ivop/osi600d/doc/osi600d-reference.pdf

OSI600D

Source: | kicad/OSI600D.kicad_sch
Date: | Wed 23 Apr 2025 11:26:50 PM CEST
Reference(s) Value | LibPart | Footprint
C1 | 10mF | Device:C_Polarized | Capacitor_THT:C_Radial_D10.0mm_H16.0mm_P5.00mm
C2 | 10n | Device:C_Polarized | Capacitor_THT:CP_Axial_L10.0mm_D4.5mm_P15.00mm_Horizontal
C3 | 33u | Device:C_Polarized | Capacitor_THT:CP_Axial_L10.0mm_D4.5mm_P15.00mm_Horizontal
C4 | 33u | Device:C_Polarized | Capacitor_THT:CP_Axial_L10.0mm_D4.5mm_P15.00mm_Horizontal
C5 | 47u | Device:C_Polarized | Capacitor_THT:CP_Axial_L10.0mm_D4.5mm_P15.00mm_Horizontal
C6 | 150p | Device:C | OSI600D:C_Disc_D7.5mm_W2.5mm_P7.50mm
C7 | 1n | Device:C | OSI600D:C_Disc_D7.5mm_W2.5mm_P7.50mm
C8 | 100n | Device:C | Capacitor_THT:C_Disc_D5.1mm_W3.2mm_P5.00mm
C9 | 68p | Device:C | OSI600D:C_Disc_D7.5mm_W2.5mm_P7.50mm
C10 | 10n | Device:C | OSI600D:C_Disc_D7.5mm_W2.5mm_P7.50mm
C11 | 100n | Device:C | OSI600D:C_Disc_D7.5mm_W2.5mm_P7.50mm
C12 | 1n | Device:C | OSI600D:C_Disc_D7.5mm_W2.5mm_P7.50mm
C13 | 10n | Device:C | OSI600D:C_Disc_D7.5mm_W2.5mm_P7.50mm
C55 | 1n | Device:C | OSI600D:C_Disc_D7.5mm_W2.5mm_P7.50mm
C57 | 27p | Device:C | Capacitor_THT:C_Disc_D4.3mm_W1.9mm_P5.00mm
C60 | 1n | Device:C | OSI600D:C_Disc_D7.5mm_W2.5mm_P7.50mm
C61 | 150p | Device:C | OSI600D:C_Disc_D7.5mm_W2.5mm_P7.50mm
C62 | 100n | Device:C | OSI600D:C_Disc_D7.5mm_W2.5mm_P7.50mm
C63 | 47u | Device:C_Polarized | Capacitor_THT:CP_Axial_L11.0mm_D5.0mm_P18.00mm_Horizontal
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
JP28 | Jumper_2_Bridged | Jumper:Jumper_2_BridgeOSI600D:Closed_PinHeader_1x02_P2.54mm_Vertical
JP29 | Jumper_2_Bridged | Jumper:Jumper_2_BridgeOSI600D:Closed_PinHeader_1x02_P2.54mm_Vertical
JP30 | Jumper_2_Open | Jumper:Jumper_2_Open Connector_PinHeader_2.54mm:PinHeader_1x02_P2.54mm_Vertical
JP31 | Jumper_2_Open | Jumper:Jumper_2_Open Connector_PinHeader_2.54mm:PinHeader_1x02_P2.54mm_Vertical
KEY1 | 1 | OSI600D:KEY SWITCH OSI600D:SW_Cherry_MX_PCB_1.00u
KEY2 | 8 | OSI600D:KEY SWITCH OSI600D:SW_Cherry_MX_PCB_1.00u
KEY3 | . | OSI600D:KEY SWITCH OSI600D:SW_Cherry_MX_PCB_1.00u
KEY4 | W | OSI600D:KEY SWITCH OSI600D:SW_Cherry_MX_PCB_1.00u
KEY5 | S | OSI600D:KEY SWITCH OSI600D:SW_Cherry_MX_PCB_1.00u
KEY6 | X | OSI600D:KEY SWITCH OSI600D:SW_Cherry_MX_PCB_1.00u
KEY7 | Q | OSI600D:KEY SWITCH OSI600D:SW_Cherry_MX_PCB_1.00u
KEY8 | REPT | OSI600D:KEY SWITCH OSI600D:SW_Cherry_MX_PCB_1.00u
KEY9 | 2 | OSI600D:KEY SWITCH OSI600D:SW_Cherry_MX_PCB_1.00u
KEY10 | 9 | OSI600D:KEY SWITCH OSI600D:SW_Cherry_MX_PCB_1.00u
KEY11 | L | OSI600D:KEY SWITCH OSI600D:SW_Cherry_MX_PCB_1.00u
KEY12 | E | OSI600D:KEY SWITCH OSI600D:SW_Cherry_MX_PCB_1.00u
KEY13 | D | OSI600D:KEY SWITCH OSI600D:SW_Cherry_MX_PCB_1.00u
KEY14 | C | OSI600D:KEY SWITCH OSI600D:SW_Cherry_MX_PCB_1.00u
KEY15 | A | OSI600D:KEY SWITCH OSI600D:SW_Cherry_MX_PCB_1.00u
KEY16 | CTRL | OSI600D:KEY SWITCH OSI600D:SW_Cherry_MX_PCB_1.00u
KEY17 | 3 | OSI600D:KEY SWITCH OSI600D:SW_Cherry_MX_PCB_1.00u
KEY18 | 0 | OSI600D:KEY SWITCH OSI600D:SW_Cherry_MX_PCB_1.00u
KEY19 | O | OSI600D:KEY SWITCH OSI600D:SW_Cherry_MX_PCB_1.00u
KEY20 | R | OSI600D:KEY SWITCH OSI600D:SW_Cherry_MX_PCB_1.00u
KEY21 | F | OSI600D:KEY SWITCH OSI600D:SW_Cherry_MX_PCB_1.00u
KEY22 | V | OSI600D:KEY SWITCH OSI600D:SW_Cherry_MX_PCB_1.00u
KEY23 | Z | OSI600D:KEY SWITCH OSI600D:SW_Cherry_MX_PCB_1.00u
KEY24 | ESC | OSI600D:KEY SWITCH OSI600D:SW_Cherry_MX_PCB_1.00u
KEY25 | 4 | OSI600D:KEY SWITCH OSI600D:SW_Cherry_MX_PCB_1.00u
KEY26 | : | OSI600D:KEY SWITCH OSI600D:SW_Cherry_MX_PCB_1.00u
KEY27 | LF | OSI600D:KEY SWITCH OSI600D:SW_Cherry_MX_PCB_1.00u
KEY28 | T | OSI600D:KEY SWITCH OSI600D:SW_Cherry_MX_PCB_1.00u
KEY29 | G | OSI600D:KEY SWITCH OSI600D:SW_Cherry_MX_PCB_1.00u
KEY30 | B | OSI600D:KEY SWITCH OSI600D:SW_Cherry_MX_PCB_1.00u
KEY31 | SPACE | OSI600D:KEY SWITCH OSI600D:SW_Cherry_MX_PCB_1.00u
KEY32 | 5 | OSI600D:KEY SWITCH OSI600D:SW_Cherry_MX_PCB_1.00u
KEY33 | - | OSI600D:KEY SWITCH OSI600D:SW_Cherry_MX_PCB_1.00u
KEY34 | RET | OSI600D:KEY SWITCH OSI600D:SW_Cherry_MX_PCB_1.50u
KEY35 | Y | OSI600D:KEY SWITCH OSI600D:SW_Cherry_MX_PCB_1.00u

KEY36 | H | OSI600D:KEY SWITCH OSI600D:SW_Cherry_MX_PCB_1.00u
KEY37 | N | OSI600D:KEY SWITCH OSI600D:SW_Cherry_MX_PCB_1.00u
KEY38 | ?/ | OSI600D:KEY SWITCH OSI600D:SW_Cherry_MX_PCB_1.00u
KEY39 | 6 | OSI600D:KEY SWITCH OSI600D:SW_Cherry_MX_PCB_1.00u
KEY40 | RUB | OSI600D:KEY SWITCH OSI600D:SW_Cherry_MX_PCB_1.00u
KEY41 | U | OSI600D:KEY SWITCH OSI600D:SW_Cherry_MX_PCB_1.00u
KEY42 | J | OSI600D:KEY SWITCH OSI600D:SW_Cherry_MX_PCB_1.00u
KEY43 | M | OSI600D:KEY SWITCH OSI600D:SW_Cherry_MX_PCB_1.00u
KEY44 | ; | OSI600D:KEY SWITCH OSI600D:SW_Cherry_MX_PCB_1.00u
KEY45 | LSHFT | OSI600D:KEY SWITCH OSI600D:SW_Cherry_MX_PCB_1.50u
KEY46 | 7 | OSI600D:KEY SWITCH OSI600D:SW_Cherry_MX_PCB_1.00u
KEY47 | I | OSI600D:KEY SWITCH OSI600D:SW_Cherry_MX_PCB_1.00u
KEY48 | K | OSI600D:KEY SWITCH OSI600D:SW_Cherry_MX_PCB_1.00u
KEY49 | , | OSI600D:KEY SWITCH OSI600D:SW_Cherry_MX_PCB_1.00u
KEY50 | P | OSI600D:KEY SWITCH OSI600D:SW_Cherry_MX_PCB_1.00u
KEY51 | RSHFT | OSI600D:KEY SWITCH OSI600D:SW_Cherry_MX_PCB_1.50u
KEY52 | SHFTLK | OSI600D:KEY SWITCH OSI600D:SW_Cherry_MX_PCB_1.00u
KEY53 | BREAK | Switch:SW_Push | OSI600D:SW_Cherry_MX_PCB_1.00u
LED1 | LED | Device:LED | LED_THT:LED_D5.0mm
PIN1 | JUMPER_PIN | OSI600D:JUMPER_PIN Connector_PinHeader_2.54mm:PinHeader_1x01_P2.54mm_Vertical
PIN2 | JUMPER_PIN | OSI600D:JUMPER_PIN Connector_PinHeader_2.54mm:PinHeader_1x01_P2.54mm_Vertical
PIN3 | JUMPER_PIN | OSI600D:JUMPER_PIN Connector_PinHeader_2.54mm:PinHeader_1x01_P2.54mm_Vertical
PIN4 | JUMPER_PIN | OSI600D:JUMPER_PIN Connector_PinHeader_2.54mm:PinHeader_1x01_P2.54mm_Vertical
PIN5 | JUMPER_PIN | OSI600D:JUMPER_PIN Connector_PinHeader_2.54mm:PinHeader_1x01_P2.54mm_Vertical
PIN6 | JUMPER_PIN | OSI600D:JUMPER_PIN Connector_PinHeader_2.54mm:PinHeader_1x01_P2.54mm_Vertical
PIN7 | JUMPER_PIN | OSI600D:JUMPER_PIN Connector_PinHeader_2.54mm:PinHeader_1x01_P2.54mm_Vertical
PIN8 | JUMPER_PIN | OSI600D:JUMPER_PIN Connector_PinHeader_2.54mm:PinHeader_1x01_P2.54mm_Vertical
PIN9 | JUMPER_PIN | OSI600D:JUMPER_PIN Connector_PinHeader_2.54mm:PinHeader_1x01_P2.54mm_Vertical
PIN10 | JUMPER_PIN | OSI600D:JUMPER_PIN Connector_PinHeader_2.54mm:PinHeader_1x01_P2.54mm_Vertical
PIN11 | JUMPER_PIN | OSI600D:JUMPER_PIN Connector_PinHeader_2.54mm:PinHeader_1x01_P2.54mm_Vertical
PIN12 | JUMPER_PIN | OSI600D:JUMPER_PIN Connector_PinHeader_2.54mm:PinHeader_1x01_P2.54mm_Vertical
PIN13 | JUMPER_PIN | OSI600D:JUMPER_PIN Connector_PinHeader_2.54mm:PinHeader_1x01_P2.54mm_Vertical
PIN14 | JUMPER_PIN | OSI600D:JUMPER_PIN Connector_PinHeader_2.54mm:PinHeader_1x01_P2.54mm_Vertical
PIN15 | JUMPER_PIN | OSI600D:JUMPER_PIN Connector_PinHeader_2.54mm:PinHeader_1x01_P2.54mm_Vertical
PIN16 | JUMPER_PIN | OSI600D:JUMPER_PIN Connector_PinHeader_2.54mm:PinHeader_1x01_P2.54mm_Vertical
PIN17 | JUMPER_PIN | OSI600D:JUMPER_PIN Connector_PinHeader_2.54mm:PinHeader_1x01_P2.54mm_Vertical
PIN18 | JUMPER_PIN | OSI600D:JUMPER_PIN Connector_PinHeader_2.54mm:PinHeader_1x01_P2.54mm_Vertical
Q1 | 2N5226 | Transistor_BJT:2N3906 Package_TO_SOT_THT:TO-92_Inline_Wide
Q2 | 2N5225 | Transistor_BJT:2N2219 Package_TO_SOT_THT:TO-92_Inline_Wide
R1 | 4K7 | Device:R | Resistor_THT:R_Axial_DIN0207_L6.3mm_D2.5mm_P2.54mm_Vertical
R2 | 4K7 | Device:R | Resistor_THT:R_Axial_DIN0207_L6.3mm_D2.5mm_P2.54mm_Vertical
R3 | 4K7 | Device:R | Resistor_THT:R_Axial_DIN0207_L6.3mm_D2.5mm_P2.54mm_Vertical
R4 | 4K7 | Device:R | Resistor_THT:R_Axial_DIN0207_L6.3mm_D2.5mm_P2.54mm_Vertical
R5 | 4K7 | Device:R | Resistor_THT:R_Axial_DIN0207_L6.3mm_D2.5mm_P2.54mm_Vertical
R6 | 4K7 | Device:R | Resistor_THT:R_Axial_DIN0207_L6.3mm_D2.5mm_P2.54mm_Vertical
R7 | 4K7 | Device:R | Resistor_THT:R_Axial_DIN0207_L6.3mm_D2.5mm_P2.54mm_Vertical
R8 | 4K7 | Device:R | Resistor_THT:R_Axial_DIN0207_L6.3mm_D2.5mm_P2.54mm_Vertical
R9 | 220 | Device:R | Resistor_THT:R_Axial_DIN0207_L6.3mm_D2.5mm_P2.54mm_Vertical
R10 | 4K7 | Device:R | Resistor_THT:R_Axial_DIN0207_L6.3mm_D2.5mm_P2.54mm_Vertical
R11 | 4K7 | Device:R | Resistor_THT:R_Axial_DIN0207_L6.3mm_D2.5mm_P2.54mm_Vertical
R32 | 1K | Device:R | Resistor_THT:R_Axial_DIN0207_L6.3mm_D2.5mm_P2.54mm_Vertical
R33 | 10K | Device:R | Resistor_THT:R_Axial_DIN0207_L6.3mm_D2.5mm_P2.54mm_Vertical
R34 | 10K | Device:R | Resistor_THT:R_Axial_DIN0207_L6.3mm_D2.5mm_P2.54mm_Vertical

R35 | 470 | Device:R | Resistor_THT:R_Axial_DIN0207_L6.3mm_D2.5mm_P2.54mm_Vertical
R36 | 470 | Device:R | Resistor_THT:R_Axial_DIN0207_L6.3mm_D2.5mm_P2.54mm_Vertical
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
U12 | BASIC 4 | OSI600D:2316B{slash}26Package_DIP:DIP-24_W15.24mm_Socket_LongPads
U13 | 2316B/2716 | OSI600D:2316B{slash}27Package_DIP:DIP-24_W15.24mm_Socket_LongPads
U14 | 6850 | OSI600D:6850 | Package_DIP:DIP-24_W15.24mm_Socket_LongPads
U15 | LS02 | 74xx:74LS02 | Package_DIP:DIP-14_W7.62mm_Socket_LongPads
U16 | LS04 | 74xx:74LS04 | Package_DIP:DIP-14_W7.62mm_Socket_LongPads
U17 | LS139 | 74xx:74LS139 | Package_DIP:DIP-16_W7.62mm_Socket_LongPads
U18 | LS04 | 74xx:74LS04 | Package_DIP:DIP-14_W7.62mm_Socket_LongPads
U19 | LS20 | OSI600D:LS20 | Package_DIP:DIP-14_W7.62mm_Socket_LongPads
U20 | LS138 | OSI600D:LS138 U20 | Package_DIP:DIP-16_W7.62mm_Socket_LongPads
U21 | LS04 | 74xx:74LS04 | Package_DIP:DIP-14_W7.62mm_Socket_LongPads
U22 | LS138 | 74xx:74LS138 | Package_DIP:DIP-16_W7.62mm_Socket_LongPads
U23 | LS138 | OSI600D:LS138 | Package_DIP:DIP-16_W7.62mm_Socket_LongPads
U24 | 8T28 | OSI600D:8T28 RE{slas Package_DIP:DIP-16_W7.62mm_Socket_LongPads
U25 | 8T28 | OSI600D:8T28 RE{slas Package_DIP:DIP-16_W7.62mm_Socket_LongPads
U29 | LS93 | OSI600D:7493 | Package_DIP:DIP-14_W7.62mm_Socket_LongPads
U30 | LS163 | OSI600D:LS163 | Package_DIP:DIP-16_W7.62mm_Socket_LongPads
U31 | 2114 CS BOTTOM | OSI600D:2114 CS BOT Package_DIP:DIP-18_W7.62mm_Socket_LongPads
U32 | 2114 CS BOTTOM | OSI600D:2114 CS BOT Package_DIP:DIP-18_W7.62mm_Socket_LongPads
U33 | 2114 CS BOTTOM | OSI600D:2114 CS BOT Package_DIP:DIP-18_W7.62mm_Socket_LongPads

U34 | 2114 CS BOTTOM | OSI600D:2114 CS BOT Package_DIP:DIP-18_W7.62mm_Socket_LongPads
U35 | 2114 CS BOTTOM | OSI600D:2114 CS BOT Package_DIP:DIP-18_W7.62mm_Socket_LongPads
U36 | 2114 CS BOTTOM | OSI600D:2114 CS BOT Package_DIP:DIP-18_W7.62mm_Socket_LongPads
U37 | 2114 CS BOTTOM | OSI600D:2114 CS BOT Package_DIP:DIP-18_W7.62mm_Socket_LongPads
U38 | 2114 CS BOTTOM | OSI600D:2114 CS BOT Package_DIP:DIP-18_W7.62mm_Socket_LongPads
U39 | 2114 CS BOTTOM COMOSI600D:2114 CS BOT Package_DIP:DIP-18_W7.62mm_Socket_LongPads
U40 | 2114 CS TOP COMPACOSI600D:2114 CS TOP Package_DIP:DIP-18_W7.62mm_Socket_LongPads
U41 | CHARGEN | OSI600D:CHARGEN | Package_DIP:DIP-24_W15.24mm_Socket_LongPads
U42 | LS165 | OSI600D:LS165 | Package_DIP:DIP-16_W7.62mm_Socket_LongPads
U43 | '08 | 74xx:74LS08 | Package_DIP:DIP-14_W7.62mm_Socket_LongPads
U45 | 2114 CS TOP | OSI600D:2114 CS TOP Package_DIP:DIP-18_W7.62mm_Socket_LongPads
U46 | 2114 CS TOP | OSI600D:2114 CS TOP Package_DIP:DIP-18_W7.62mm_Socket_LongPads
U47 | 2114 CS TOP | OSI600D:2114 CS TOP Package_DIP:DIP-18_W7.62mm_Socket_LongPads
U48 | 2114 CS TOP | OSI600D:2114 CS TOP Package_DIP:DIP-18_W7.62mm_Socket_LongPads
U49 | 2114 CS TOP | OSI600D:2114 CS TOP Package_DIP:DIP-18_W7.62mm_Socket_LongPads
U50 | 2114 CS TOP | OSI600D:2114 CS TOP Package_DIP:DIP-18_W7.62mm_Socket_LongPads
U51 | 2114 CS TOP | OSI600D:2114 CS TOP Package_DIP:DIP-18_W7.62mm_Socket_LongPads
U52 | 2114 CS TOP | OSI600D:2114 CS TOP Package_DIP:DIP-18_W7.62mm_Socket_LongPads
U53 | LS157 | OSI600D:LS157 ALT | Package_DIP:DIP-16_W7.62mm_Socket_LongPads
U54 | LS157 | OSI600D:LS157 ALT | Package_DIP:DIP-16_W7.62mm_Socket_LongPads
U55 | LS157 | OSI600D:LS157 ALT | Package_DIP:DIP-16_W7.62mm_Socket_LongPads
U56 | LS20 | OSI600D:LS20 | Package_DIP:DIP-14_W7.62mm_Socket_LongPads
U57 | LS163 | OSI600D:LS163 ALT2 | Package_DIP:DIP-16_W7.62mm_Socket_LongPads
U58 | '00 | 74xx:7400 | Package_DIP:DIP-14_W7.62mm_Socket_LongPads
U59 | LS163 | OSI600D:LS163 ALT | Package_DIP:DIP-16_W7.62mm_Socket_LongPads
U60 | LS163 | OSI600D:LS163 ALT | Package_DIP:DIP-16_W7.62mm_Socket_LongPads
U61 | LS163 | OSI600D:LS163 ALT | Package_DIP:DIP-16_W7.62mm_Socket_LongPads
U62 | LS04 | 74xx:74LS04 | Package_DIP:DIP-14_W7.62mm_Socket_LongPads
U63 | '74 | 74xx:74LS74 | Package_DIP:DIP-14_W7.62mm_Socket_LongPads
U64 | LS76 | 74xx:74LS76 | Package_DIP:DIP-16_W7.62mm_Socket_LongPads
U65 | '123 | OSI600D:74123 | Package_DIP:DIP-16_W7.62mm_Socket_LongPads
U66 | CA3130 | Amplifier_Operational:C Package_DIP:DIP-8_W7.62mm_Socket_LongPads
U67 | LS14 | 74xx:74LS14 | Package_DIP:DIP-14_W7.62mm_Socket_LongPads
U68 | '17 | OSI600D:SN7417 | Package_DIP:DIP-14_W7.62mm_Socket_LongPads
U69 | '123 | OSI600D:74123 | Package_DIP:DIP-16_W7.62mm_Socket_LongPads
U70 | '03 | 74xx:74LS03 | Package_DIP:DIP-14_W7.62mm_Socket_LongPads
U72 | LS174 | 74xx:74LS174 | Package_DIP:DIP-16_W7.62mm_Socket_LongPads
U73 | LS138 | OSI600D:LS138 U73 | Package_DIP:DIP-16_W7.62mm_Socket_LongPads
U74 | 8T28 | OSI600D:8T28 RE{slas Package_DIP:DIP-16_W7.62mm_Socket_LongPads
U76 | '74 | 74xx:74LS74 | Package_DIP:DIP-14_W7.62mm_Socket_LongPads
U77 | 2114 CS TOP COMPACOSI600D:2114 CS TOP Package_DIP:DIP-18_W7.62mm_Socket_LongPads
U78 | LS157 | OSI600D:LS157 | Package_DIP:DIP-16_W7.62mm_Socket_LongPads
U79 | LS86 | 74xx:74LS86 | Package_DIP:DIP-14_W7.62mm_Socket_LongPads
U80 | LM393 | Comparator:LM393 | Package_DIP:DIP-8_W7.62mm_Socket_LongPads
X1 | 3.932160 MHz | Device:Crystal | Crystal:Crystal_HC49-U_Horizontal
