ivop/osi600d/doc/osi600d-bom.pdf

OSI600D

## Ohio Scientific Model 600D April 2025 Edition BOM

Capacitors (Polarized)

Qty | Value | Ordered | Price | Total | Received
1 | 10n
2 | 33u
2 | 47u
1 | 50u
1 | 10mF

Capacitors (Non-polarized)

Qty | Value | Ordered | Price | Total | Received
1 | 27p
1 | 68p
3 | 150p
4 | 1n
2 | 10n
42 | 100n

Diodes

Qty | Value | Ordered | Price | Total | Received
1 | 1N4001
26 | 1N914
1 | LED

Resistors

Qty | Value | Ordered | Price | Total | Received
1 | 100
9 | 220
7 | 390
4 | 470
2 | 510
9 | 1K
1 | 2K
1 | 3K9
12 | 4K7
1 | 8K2
28 | 10K
1 | 16K
1 | 33K
1 | 68K
4 | 100K
4 | 1M
1 | 10M

Trim Potentiometers

Qty | Value | Ordered | Price | Total | Received
1 | 5K
1 | 10K

Transistors

Qty | Value | Ordered | Price | Total | Received
1 | 2N5226
1 | 2N5225

Miscellaneous

Qty | Value | Ordered | Price | Total | Received
1 | Crystal 3.932160 MHz HC49-U
53 | Cherry MX Key Switch
1 | SS12D00 Slide Switch
2 | Fuse Clip
1 | Fuse 5A 200V
1 | VS-KBPC602 Rectifier
1 | USB-C 4 Pins 100mils Breakout Board
2 | 01x40 Male Pin Header
25 | Pin Header Jumper Shunt
0 | Dupont Jumper Wires (optional)

IC Sockets

Qty | Value | Ordered | Price | Total | Received
2 | DIP-8 W7.62mm
12 | DIP-14 W7.62mm
20 | DIP-16 W7.62mm
19 | DIP-18 W7.62mm
7 | DIP-24 W15.24
2 | DIP-40 W15.24

Connectors

Qty | Value | Ordered | Price | Total | Received
2 | Molex 3.96mm 12 pins
2 | Molex 3.96mm 2 pins

ICs

Qty | Value | Ordered | Price | Total | Received
1 | '00
1 | '03

1 | '08
2 | '123
1 | '17
2 | '74
19 | 2114 SRAM
6 | 2716 EPROM
5 | 8T28
1 | CA3130
1 | LM393
1 | LS02
4 | LS04
1 | LS14
2 | LS20
2 | LS75
1 | LS76
1 | LS86
1 | LS93
2 | LS125
4 | LS138
1 | LS139
4 | LS157
5 | LS163
1 | LS165
1 | LS174
1 | MC6850
1 | R6502
