ivop/osi600d/kicad/3dmodels/SW_Cherry_MX_PCB.stp

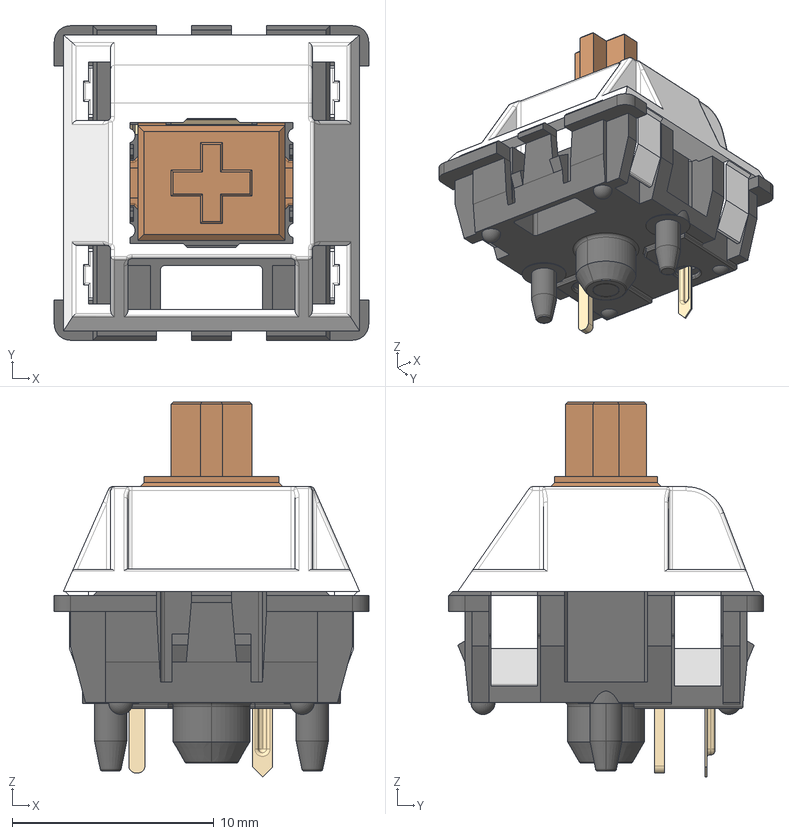
[picture p2: CAD file, 2025-04-29]
kicad/3dmodels/SW_Cherry_MX_PCB.stp
15.6 x 15.6 x 18.6 mm
