ivop/osi600d/kicad/3dmodels/Stabilizer_Cherry_MX_6.25u.stp

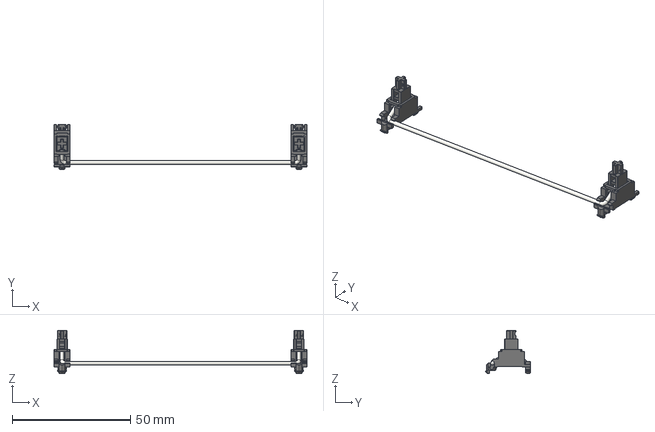
[picture p3: CAD file, 2025-04-29]
kicad/3dmodels/Stabilizer_Cherry_MX_6.25u.stp
106.8 x 19.2 x 18.3 mm
