ivop/osi600d/kicad/3dmodels/jumper_aksnt_g-black.stp

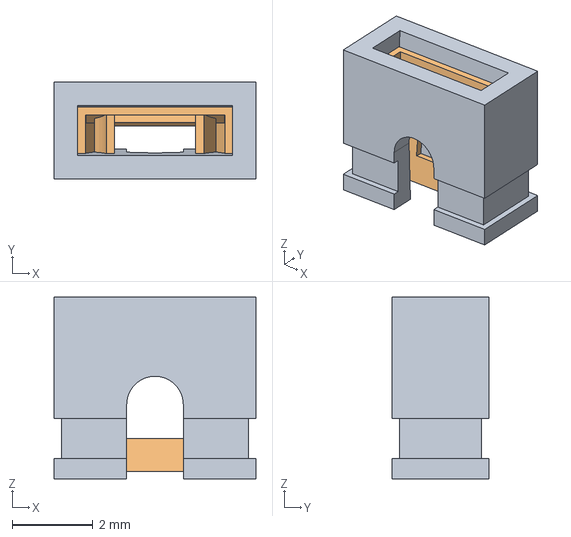
[picture p4: CAD file, 2025-04-29]
kicad/3dmodels/jumper_aksnt_g-black.stp
5.00 x 2.40 x 4.50 mm
