ivop/osi600d/kicad/3dmodels/SS12D00G4.STEP

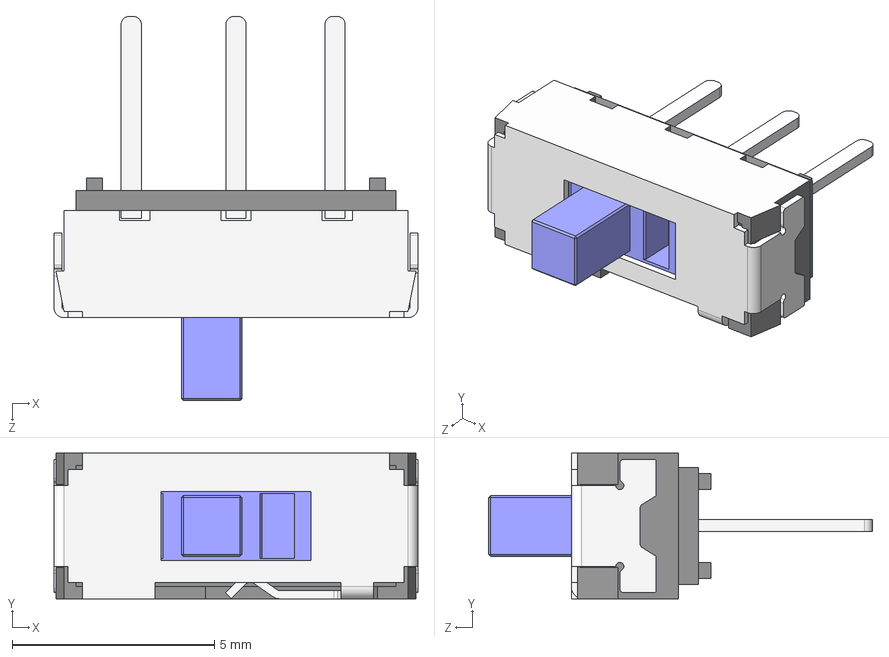
[picture p5: CAD file, 2025-04-29]
kicad/3dmodels/SS12D00G4.STEP
9.00 x 3.60 x 9.50 mm
