ivop/osi600d/kicad/3dmodels/SW_Cherry_MX_Plate.stp

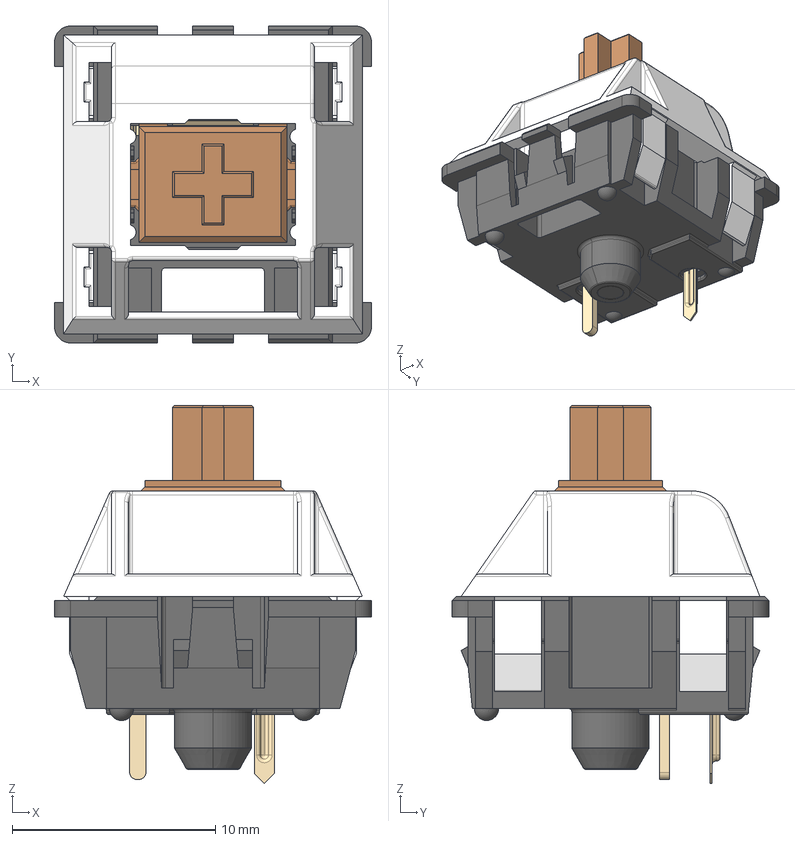
[picture p6: CAD file, 2025-04-29]
kicad/3dmodels/SW_Cherry_MX_Plate.stp
15.6 x 15.6 x 18.6 mm
