ivop/osi600d/kicad/3dmodels/Clips LF-102071 with fuse 6_3x32.STEP

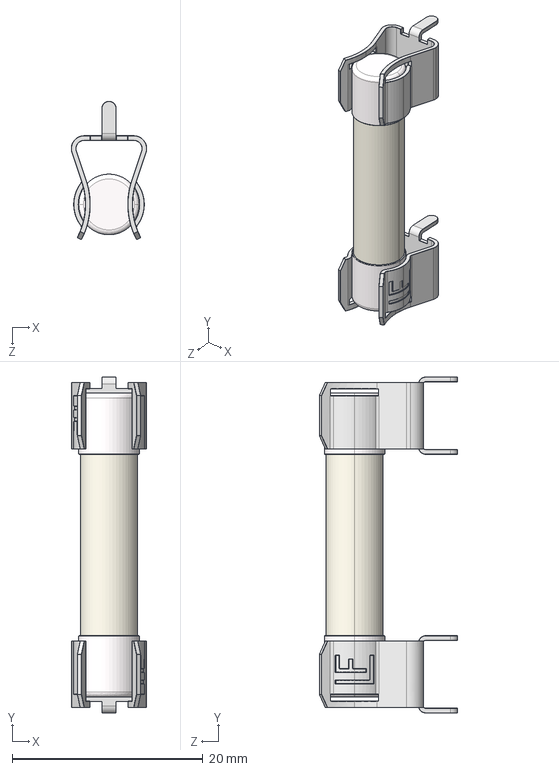
[picture p7: CAD file, 2025-04-29]
kicad/3dmodels/Clips LF-102071 with fuse 6_3x32.STEP
7.90 x 35.2 x 14.5 mm
LF 102071 x 2
6,3x32
