ivop/osi600d/kicad/3dmodels/41791-0832.stp

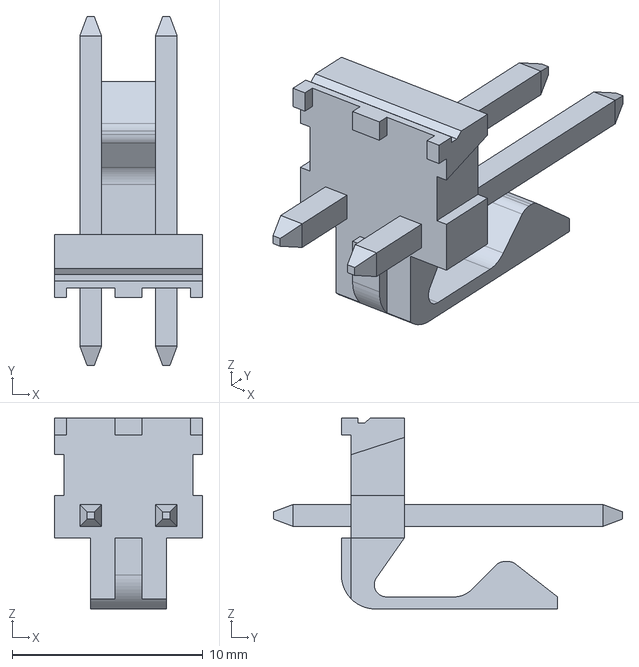
[picture p8: CAD file, 2025-04-29]
kicad/3dmodels/41791-0832.stp
7.77 x 18.3 x 10.0 mm
