ivop/osi600d/kicad/3dmodels/417910842.stp

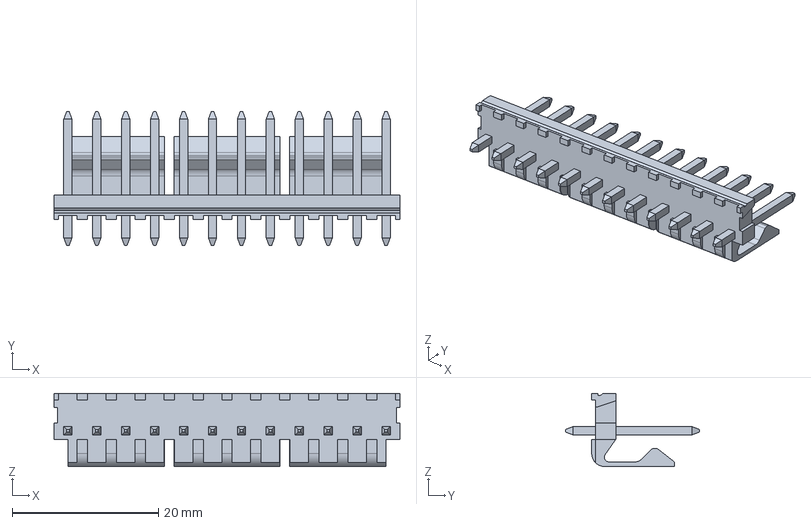
[picture p9: CAD file, 2025-04-29]
kicad/3dmodels/417910842.stp
47.4 x 18.3 x 10.0 mm
