ivop/osi600d/kicad/OSI600D.kicad_pcb

## KiCad design kicad/OSI600D.kicad_pcb (2025-08-18)

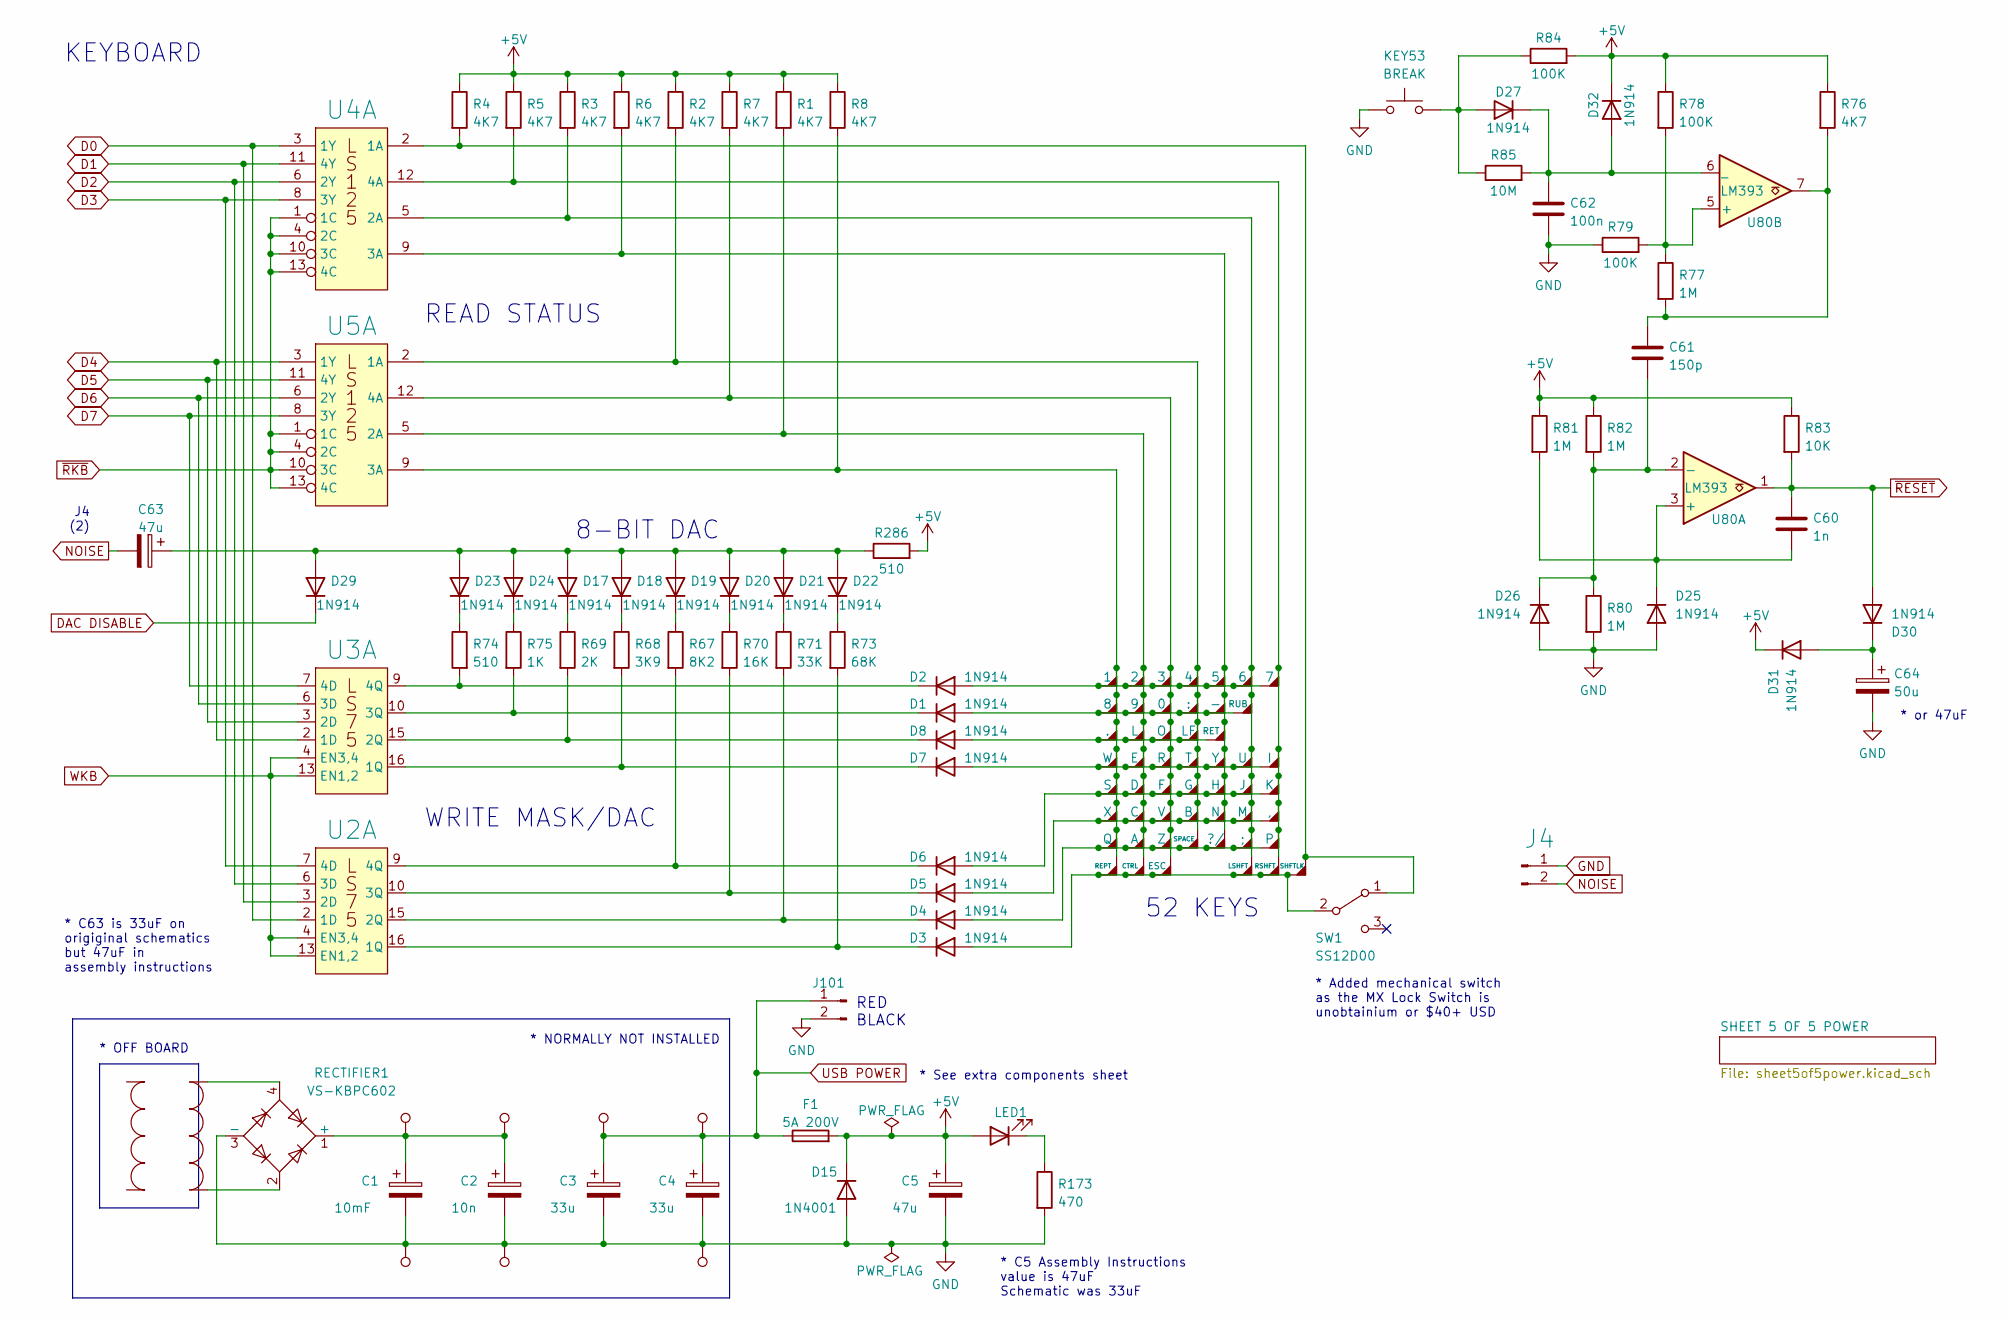
[picture p22: schematic sheet5of5.kicad_sch, SUPERBOARD 2 MODEL 600 REV. D]

Parts:
C1: 10mF; C_Radial_D10.0mm_H16.0mm_P5.00mm
C2: 10n; CP_Axial_L10.0mm_D4.5mm_P15.00mm_Horizontal
C3, C4: 33u; CP_Axial_L10.0mm_D4.5mm_P15.00mm_Horizontal
C5: 47u; CP_Axial_L10.0mm_D4.5mm_P15.00mm_Horizontal
C60: 1n; C_Disc_D7.5mm_W2.5mm_P7.50mm
C61: 150p; C_Disc_D7.5mm_W2.5mm_P7.50mm
C62: 100n; C_Disc_D7.5mm_W2.5mm_P7.50mm
C63: 47u; CP_Axial_L11.0mm_D5.0mm_P18.00mm_Horizontal
C64: 50u; CP_Axial_L11.0mm_D5.0mm_P18.00mm_Horizontal
D1, D2, D3, D4, D5, D6, D7, D8, D17, D18, D19, D20, D21, D22, D23, D24, D25, D26, D27, D29, D30, D31, D32: 1N914; D_DO-35_SOD27_P10.16mm_Horizontal
D15: 1N4001; D_DO-41_SOD81_P12.70mm_Horizontal
F1: 5A 200V; Fuse Holder
J4, J101: Conn_01x02_Male; Molex_KK-396_A-41791-0002_1x02_P3.96mm_Vertical
KEY1: 1; SW_Cherry_MX_PCB_1.00u
KEY2: 8; SW_Cherry_MX_PCB_1.00u
KEY3: .; SW_Cherry_MX_PCB_1.00u
KEY4: W; SW_Cherry_MX_PCB_1.00u
KEY5: S; SW_Cherry_MX_PCB_1.00u
KEY6: X; SW_Cherry_MX_PCB_1.00u
KEY7: Q; SW_Cherry_MX_PCB_1.00u
KEY8: REPT; SW_Cherry_MX_PCB_1.00u
KEY9: 2; SW_Cherry_MX_PCB_1.00u
KEY10: 9; SW_Cherry_MX_PCB_1.00u
KEY11: L; SW_Cherry_MX_PCB_1.00u
KEY12: E; SW_Cherry_MX_PCB_1.00u
KEY13: D; SW_Cherry_MX_PCB_1.00u
KEY14: C; SW_Cherry_MX_PCB_1.00u
KEY15: A; SW_Cherry_MX_PCB_1.00u
KEY16: CTRL; SW_Cherry_MX_PCB_1.00u
KEY17: 3; SW_Cherry_MX_PCB_1.00u
KEY18: 0; SW_Cherry_MX_PCB_1.00u
KEY19: O; SW_Cherry_MX_PCB_1.00u
KEY20: R; SW_Cherry_MX_PCB_1.00u
KEY21: F; SW_Cherry_MX_PCB_1.00u
KEY22: V; SW_Cherry_MX_PCB_1.00u
KEY23: Z; SW_Cherry_MX_PCB_1.00u
KEY24: ESC; SW_Cherry_MX_PCB_1.00u
KEY25: 4; SW_Cherry_MX_PCB_1.00u
KEY26: :; SW_Cherry_MX_PCB_1.00u
KEY27: LF; SW_Cherry_MX_PCB_1.00u
KEY28: T; SW_Cherry_MX_PCB_1.00u
KEY29: G; SW_Cherry_MX_PCB_1.00u
KEY30: B; SW_Cherry_MX_PCB_1.00u
KEY31: SPACE; SW_Cherry_MX_PCB_1.00u
KEY32: 5; SW_Cherry_MX_PCB_1.00u
KEY33: -; SW_Cherry_MX_PCB_1.00u
KEY34: RET; SW_Cherry_MX_PCB_1.50u
KEY35: Y; SW_Cherry_MX_PCB_1.00u
KEY36: H; SW_Cherry_MX_PCB_1.00u
KEY37: N; SW_Cherry_MX_PCB_1.00u
KEY38: ?/; SW_Cherry_MX_PCB_1.00u
KEY39: 6; SW_Cherry_MX_PCB_1.00u
KEY40: RUB; SW_Cherry_MX_PCB_1.00u
KEY41: U; SW_Cherry_MX_PCB_1.00u
KEY42: J; SW_Cherry_MX_PCB_1.00u
KEY43: M; SW_Cherry_MX_PCB_1.00u
KEY44: ;; SW_Cherry_MX_PCB_1.00u
KEY45: LSHFT; SW_Cherry_MX_PCB_1.50u
KEY46: 7; SW_Cherry_MX_PCB_1.00u
KEY47: I; SW_Cherry_MX_PCB_1.00u
KEY48: K; SW_Cherry_MX_PCB_1.00u
KEY49: ,; SW_Cherry_MX_PCB_1.00u
KEY50: P; SW_Cherry_MX_PCB_1.00u
KEY51: RSHFT; SW_Cherry_MX_PCB_1.50u
KEY52: SHFTLK; SW_Cherry_MX_PCB_1.00u
KEY53: BREAK; SW_Cherry_MX_PCB_1.00u
LED1: LED; LED_D5.0mm
PIN8, PIN9, PIN10, PIN11, PIN12, PIN13, PIN14: JUMPER_PIN; PinHeader_1x01_P2.54mm_Vertical
R1, R2, R3, R4, R5, R6, R7, R8: 4K7; R_Axial_DIN0207_L6.3mm_D2.5mm_P2.54mm_Vertical
R67: 8K2; R_Axial_DIN0207_L6.3mm_D2.5mm_P2.54mm_Vertical
R68: 3K9; R_Axial_DIN0207_L6.3mm_D2.5mm_P2.54mm_Vertical
R69: 2K; R_Axial_DIN0207_L6.3mm_D2.5mm_P2.54mm_Vertical
R70: 16K; R_Axial_DIN0207_L6.3mm_D2.5mm_P2.54mm_Vertical
R71: 33K; R_Axial_DIN0207_L6.3mm_D2.5mm_P2.54mm_Vertical
R73: 68K; R_Axial_DIN0207_L6.3mm_D2.5mm_P2.54mm_Vertical
R74: 510; R_Axial_DIN0207_L6.3mm_D2.5mm_P2.54mm_Vertical
R75: 1K; R_Axial_DIN0207_L6.3mm_D2.5mm_P2.54mm_Vertical
R76: 4K7; R_Axial_DIN0207_500mils_Horizontal
R77, R80, R81, R82: 1M; R_Axial_DIN0207_500mils_Horizontal
R78, R79, R84: 100K; R_Axial_DIN0207_500mils_Horizontal
R83: 10K; R_Axial_DIN0207_500mils_Horizontal
R85: 10M; R_Axial_DIN0207_500mils_Horizontal
R173: 470; R_Axial_DIN0207_L6.3mm_D2.5mm_P2.54mm_Vertical
R286: 510; R_Axial_DIN0207_500mils_Horizontal
RECTIFIER1: VS-KBPC602; Diode_Bridge_Vishay_KBPC6
SW1: SS12D00
TRANSFORMER1: TRANSFORMER_(OFF_BOARD); Molex_KK-396_A-41791-0002_1x02_P3.96mm_Vertical
U2, U3: LS75; DIP-16_W7.62mm_Socket_LongPads
U4, U5: LS125; DIP-14_W7.62mm_Socket_LongPads
U80: LM393; DIP-8_W7.62mm_Socket_LongPads

Connections:
+5V: C5.1, D15.1 (K), D31.1 (K), D32.1 (K), F1.2, LED1.2 (A), R1.1, R2.1, R3.1, R4.1, R5.1, R6.1, R7.1, R8.1, R76.1, R78.1, R81.1, R82.1, R83.1, R84.2, R286.2; also elsewhere on the board
D0: U2.2 (1D), U4.3 (1Y); also elsewhere on the board
D1: U2.3 (2D), U4.11 (4Y); also elsewhere on the board
D2: U2.6 (3D), U4.6 (2Y); also elsewhere on the board
D3: U2.7 (4D), U4.8 (3Y); also elsewhere on the board
D4: U3.2 (1D), U5.3 (1Y); also elsewhere on the board
D5: U3.3 (2D), U5.11 (4Y); also elsewhere on the board
D6: U3.6 (3D), U5.6 (2Y); also elsewhere on the board
D7: U3.7 (4D), U5.8 (3Y); also elsewhere on the board
DAC DISABLE: D29.1 (K); also elsewhere on the board
GND: C1.2, C2.2, C3.2, C4.2, C5.2, C62.2, C64.2, D15.2 (A), D25.2 (A), D26.2 (A), J4.1, J101.2, KEY53.2, PIN9.1, PIN11.1, PIN14.1, R79.1, R80.2, R173.2, RECTIFIER1.3 (-); also elsewhere on the board
NOISE: C63.2, J4.2
unnamed: C1.1, C2.1, PIN8.1, PIN10.1, RECTIFIER1.1 (+)
unnamed: C60.2, D25.1 (K), R81.2, U80.3 (+)
unnamed: C61.1, R76.2, R77.2, U80.7
unnamed: C61.2, D26.1 (K), R80.1, R82.2, U80.2 (-)
unnamed: C62.1, D27.1 (K), D32.2 (A), R85.2, U80.6 (_)
unnamed: C63.1, D17.2 (A), D18.2 (A), D19.2 (A), D20.2 (A), D21.2 (A), D22.2 (A), D23.2 (A), D24.2 (A), D29.2 (A), R286.1
unnamed: C64.1, D30.1 (K), D31.2 (A)
unnamed: D1.1 (K), R75.2, U3.10 (3Q), U3.14 (~2Q)
unnamed: D1.2 (A), KEY2.1, KEY10.1, KEY18.1, KEY26.1, KEY33.1, KEY40.1
unnamed: D2.1 (K), R74.2, U3.9 (4Q)
unnamed: D2.2 (A), KEY1.1, KEY9.1, KEY17.1, KEY25.1, KEY32.1, KEY39.1, KEY46.1
unnamed: D3.1 (K), R73.2, U2.16 (1Q)
unnamed: D3.2 (A), KEY8.1, KEY16.1, KEY24.1, KEY45.1, KEY51.1, KEY52.1, SW1.2 (B)
unnamed: D4.1 (K), R71.2, U2.15 (2Q)
unnamed: D4.2 (A), KEY7.1, KEY15.1, KEY23.1, KEY31.1, KEY38.1, KEY44.1, KEY50.1
unnamed: D5.1 (K), R70.2, U2.10 (3Q)
unnamed: D5.2 (A), KEY6.1, KEY14.1, KEY22.1, KEY30.1, KEY37.1, KEY43.1, KEY49.1
unnamed: D6.1 (K), R67.2, U2.9 (4Q)
unnamed: D6.2 (A), KEY5.1, KEY13.1, KEY21.1, KEY29.1, KEY36.1, KEY42.1, KEY48.1
unnamed: D7.1 (K), R68.2, U3.16 (1Q)
unnamed: D7.2 (A), KEY4.1, KEY12.1, KEY20.1, KEY28.1, KEY35.1, KEY41.1, KEY47.1
unnamed: D8.1 (K), R69.2, U3.15 (2Q)
unnamed: D8.2 (A), KEY3.1, KEY11.1, KEY19.1, KEY27.1, KEY34.1
unnamed: D17.1 (K), R69.1
unnamed: D18.1 (K), R68.1
unnamed: D19.1 (K), R67.1
unnamed: D20.1 (K), R70.1
unnamed: D21.1 (K), R71.1
unnamed: D22.1 (K), R73.1
unnamed: D23.1 (K), R74.1
unnamed: D24.1 (K), R75.1
unnamed: D27.2 (A), KEY53.1, R84.1, R85.1
unnamed: KEY1.2, KEY2.2, KEY3.2, KEY4.2, KEY5.2, KEY6.2, KEY7.2, KEY8.2, R8.2, U5.9 (3A)
unnamed: KEY9.2, KEY10.2, KEY11.2, KEY12.2, KEY13.2, KEY14.2, KEY15.2, KEY16.2, R1.2, U5.5 (2A)
unnamed: KEY17.2, KEY18.2, KEY19.2, KEY20.2, KEY21.2, KEY22.2, KEY23.2, KEY24.2, R7.2, U5.12 (4A)
unnamed: KEY25.2, KEY26.2, KEY27.2, KEY28.2, KEY29.2, KEY30.2, KEY31.2, R2.2, U5.2 (1A)
unnamed: KEY32.2, KEY33.2, KEY34.2, KEY35.2, KEY36.2, KEY37.2, KEY38.2, R6.2, U4.9 (3A)
unnamed: KEY39.2, KEY40.2, KEY41.2, KEY42.2, KEY43.2, KEY44.2, KEY45.2, R3.2, U4.5 (2A)
unnamed: KEY46.2, KEY47.2, KEY48.2, KEY49.2, KEY50.2, KEY51.2, R5.2, U4.12 (4A)
unnamed: KEY52.2, R4.2, SW1.1 (A), U4.2 (1A)
unnamed: LED1.1 (K), R173.1
unnamed: R77.1, R78.2, R79.2, U80.5 (+)
unnamed 171: RECTIFIER1.2, TRANSFORMER1.2; also elsewhere on the board
unnamed: RECTIFIER1.4, TRANSFORMER1.1
USB POWER: C3.1, C4.1, F1.1, J101.1, PIN12.1, PIN13.1; also elsewhere on the board
WKB: U2.4 (EN3,4), U2.13 (EN1,2), U3.4 (EN3,4), U3.13 (EN1,2); also elsewhere on the board
~RESET: C60.1, D30.2 (A), R83.2, U80.1; also elsewhere on the board
~RKB: U4.1 (1C), U4.4 (2C), U4.10 (3C), U4.13 (4C), U5.1 (1C), U5.4 (2C), U5.10 (3C), U5.13 (4C); also elsewhere on the board

Notes on the sheet:
52 KEYS
* OFF BOARD
* NORMALLY NOT INSTALLED
KEYBOARD
* C5 Assembly Instructions value is 47uF Schematic was 33uF
READ STATUS
* Added mechanical switch as the MX Lock Switch is unobtainium or $40+ USD
WRITE MASK/DAC
* or 47uF
* C63 is 33uF on origiginal schematics but 47uF in assembly instructions
* See extra components sheet
J4 (2)
8-BIT DAC
RED BLACK

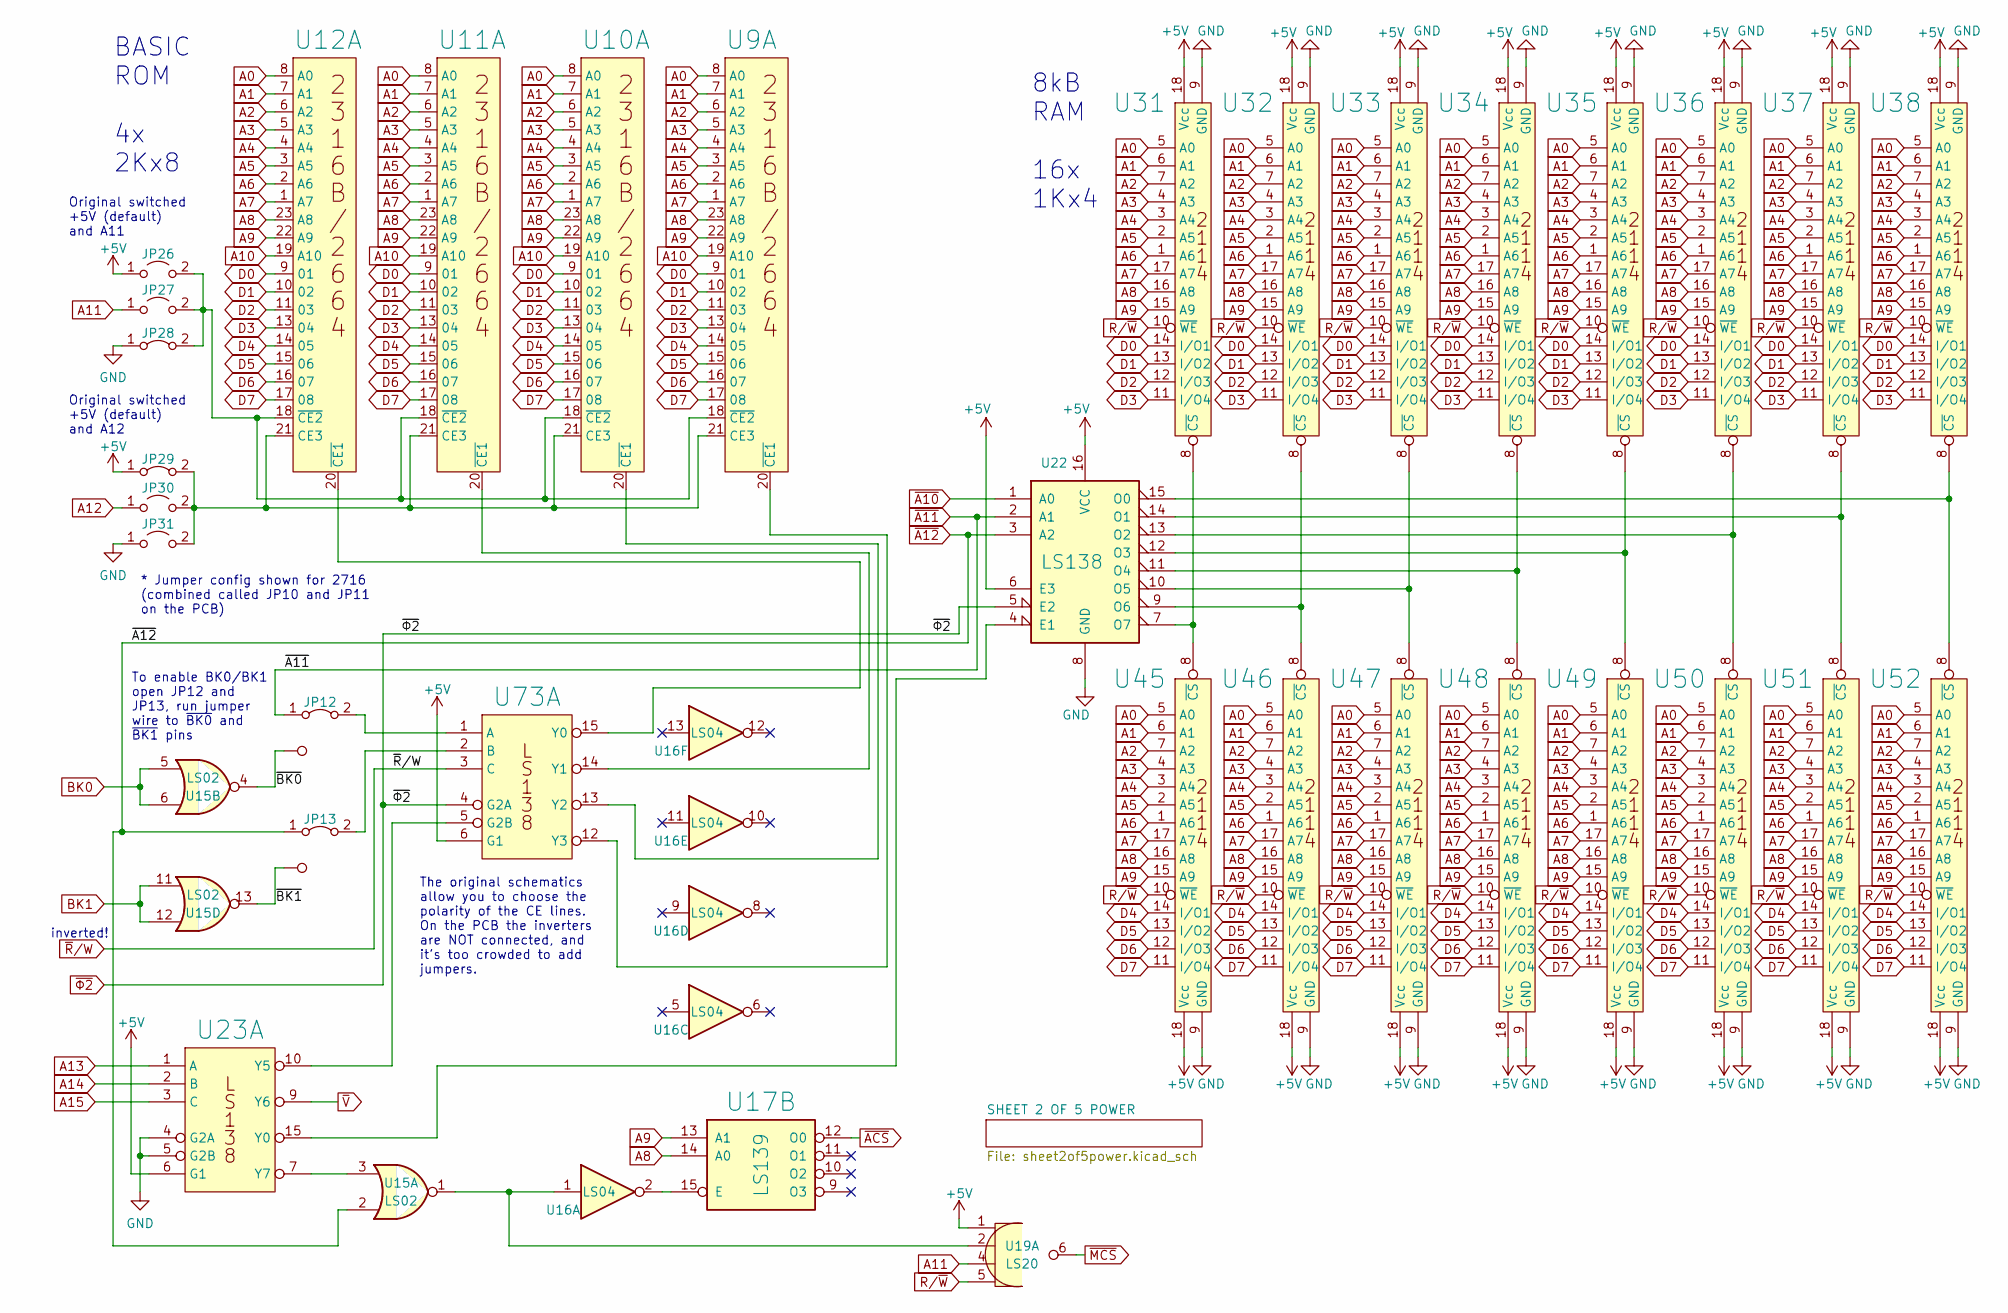
[picture p23: schematic sheet2of5.kicad_sch, SUPERBOARD 2 MODEL 600 REV. D]

Parts:
JP12, JP13, JP28, JP29: Jumper_2_Bridged; Closed_PinHeader_1x02_P2.54mm_Vertical
JP26, JP27, JP30, JP31: Jumper_2_Open; PinHeader_1x02_P2.54mm_Vertical
PIN17, PIN18: JUMPER_PIN; PinHeader_1x01_P2.54mm_Vertical
U9: BASIC 1; DIP-24_W15.24mm_Socket_LongPads
U10: BASIC 2; DIP-24_W15.24mm_Socket_LongPads
U11: BASIC 3; DIP-24_W15.24mm_Socket_LongPads
U12: BASIC 4; DIP-24_W15.24mm_Socket_LongPads
U15: LS02; DIP-14_W7.62mm_Socket_LongPads
U16: LS04; DIP-14_W7.62mm_Socket_LongPads
U17: LS139; DIP-16_W7.62mm_Socket_LongPads
U19: LS20; DIP-14_W7.62mm_Socket_LongPads
U22, U23, U73: LS138; DIP-16_W7.62mm_Socket_LongPads
U31, U32, U33, U34, U35, U36, U37, U38: 2114 CS BOTTOM; DIP-18_W7.62mm_Socket_LongPads
U45, U46, U47, U48, U49, U50, U51, U52: 2114 CS TOP; DIP-18_W7.62mm_Socket_LongPads

Connections:
+5V: JP26.1 (A), JP29.1 (A), U19.1 (1A), U22.6 (E3), U22.16 (VCC), U23.6 (G1), U31.18 (Vcc), U32.18 (Vcc), U33.18 (Vcc), U34.18 (Vcc), U35.18 (Vcc), U36.18 (Vcc), U37.18 (Vcc), U38.18 (Vcc), U45.18 (Vcc), U46.18 (Vcc), U47.18 (Vcc), U48.18 (Vcc), U49.18 (Vcc), U50.18 (Vcc), U51.18 (Vcc), U52.18 (Vcc), U73.6 (G1); also elsewhere on the board
/SHEET 2 OF 5/~BK0: PIN17.1, U15.4
/SHEET 2 OF 5/~BK1: PIN18.1, U15.13
A0: U9.8 (A0), U10.8 (A0), U11.8 (A0), U12.8 (A0), U31.5 (A0), U32.5 (A0), U33.5 (A0), U34.5 (A0), U35.5 (A0), U36.5 (A0), U37.5 (A0), U38.5 (A0), U45.5 (A0), U46.5 (A0), U47.5 (A0), U48.5 (A0), U49.5 (A0), U50.5 (A0), U51.5 (A0), U52.5 (A0); also elsewhere on the board
A1: U9.7 (A1), U10.7 (A1), U11.7 (A1), U12.7 (A1), U31.6 (A1), U32.6 (A1), U33.6 (A1), U34.6 (A1), U35.6 (A1), U36.6 (A1), U37.6 (A1), U38.6 (A1), U45.6 (A1), U46.6 (A1), U47.6 (A1), U48.6 (A1), U49.6 (A1), U50.6 (A1), U51.6 (A1), U52.6 (A1); also elsewhere on the board
A2: U9.6 (A2), U10.6 (A2), U11.6 (A2), U12.6 (A2), U31.7 (A2), U32.7 (A2), U33.7 (A2), U34.7 (A2), U35.7 (A2), U36.7 (A2), U37.7 (A2), U38.7 (A2), U45.7 (A2), U46.7 (A2), U47.7 (A2), U48.7 (A2), U49.7 (A2), U50.7 (A2), U51.7 (A2), U52.7 (A2); also elsewhere on the board
A3: U9.5 (A3), U10.5 (A3), U11.5 (A3), U12.5 (A3), U31.4 (A3), U32.4 (A3), U33.4 (A3), U34.4 (A3), U35.4 (A3), U36.4 (A3), U37.4 (A3), U38.4 (A3), U45.4 (A3), U46.4 (A3), U47.4 (A3), U48.4 (A3), U49.4 (A3), U50.4 (A3), U51.4 (A3), U52.4 (A3); also elsewhere on the board
A4: U9.4 (A4), U10.4 (A4), U11.4 (A4), U12.4 (A4), U31.3 (A4), U32.3 (A4), U33.3 (A4), U34.3 (A4), U35.3 (A4), U36.3 (A4), U37.3 (A4), U38.3 (A4), U45.3 (A4), U46.3 (A4), U47.3 (A4), U48.3 (A4), U49.3 (A4), U50.3 (A4), U51.3 (A4), U52.3 (A4); also elsewhere on the board
A5: U9.3 (A5), U10.3 (A5), U11.3 (A5), U12.3 (A5), U31.2 (A5), U32.2 (A5), U33.2 (A5), U34.2 (A5), U35.2 (A5), U36.2 (A5), U37.2 (A5), U38.2 (A5), U45.2 (A5), U46.2 (A5), U47.2 (A5), U48.2 (A5), U49.2 (A5), U50.2 (A5), U51.2 (A5), U52.2 (A5); also elsewhere on the board
A6: U9.2 (A6), U10.2 (A6), U11.2 (A6), U12.2 (A6), U31.1 (A6), U32.1 (A6), U33.1 (A6), U34.1 (A6), U35.1 (A6), U36.1 (A6), U37.1 (A6), U38.1 (A6), U45.1 (A6), U46.1 (A6), U47.1 (A6), U48.1 (A6), U49.1 (A6), U50.1 (A6), U51.1 (A6), U52.1 (A6); also elsewhere on the board
A7: U9.1 (A7), U10.1 (A7), U11.1 (A7), U12.1 (A7), U31.17 (A7), U32.17 (A7), U33.17 (A7), U34.17 (A7), U35.17 (A7), U36.17 (A7), U37.17 (A7), U38.17 (A7), U45.17 (A7), U46.17 (A7), U47.17 (A7), U48.17 (A7), U49.17 (A7), U50.17 (A7), U51.17 (A7), U52.17 (A7); also elsewhere on the board
A8: U9.23 (A8), U10.23 (A8), U11.23 (A8), U12.23 (A8), U17.14 (A0), U31.16 (A8), U32.16 (A8), U33.16 (A8), U34.16 (A8), U35.16 (A8), U36.16 (A8), U37.16 (A8), U38.16 (A8), U45.16 (A8), U46.16 (A8), U47.16 (A8), U48.16 (A8), U49.16 (A8), U50.16 (A8), U51.16 (A8), U52.16 (A8); also elsewhere on the board
A9: U9.22 (A9), U10.22 (A9), U11.22 (A9), U12.22 (A9), U17.13 (A1), U31.15 (A9), U32.15 (A9), U33.15 (A9), U34.15 (A9), U35.15 (A9), U36.15 (A9), U37.15 (A9), U38.15 (A9), U45.15 (A9), U46.15 (A9), U47.15 (A9), U48.15 (A9), U49.15 (A9), U50.15 (A9), U51.15 (A9), U52.15 (A9); also elsewhere on the board
A10: U9.19 (A10), U10.19 (A10), U11.19 (A10), U12.19 (A10); also elsewhere on the board
A11: JP27.1 (A), U19.4 (1C); also elsewhere on the board
A12: JP30.1 (A); also elsewhere on the board
A13: U23.1 (A); also elsewhere on the board
A14: U23.2 (B); also elsewhere on the board
A15: U23.3 (C); also elsewhere on the board
BK0: U15.5, U15.6; also elsewhere on the board
BK1: U15.11, U15.12; also elsewhere on the board
D0: U9.9 (01), U10.9 (01), U11.9 (01), U12.9 (01), U31.14 (I/O1), U32.14 (I/O1), U33.14 (I/O1), U34.14 (I/O1), U35.14 (I/O1), U36.14 (I/O1), U37.14 (I/O1), U38.14 (I/O1); also elsewhere on the board
D1: U9.10 (02), U10.10 (02), U11.10 (02), U12.10 (02), U31.13 (I/O2), U32.13 (I/O2), U33.13 (I/O2), U34.13 (I/O2), U35.13 (I/O2), U36.13 (I/O2), U37.13 (I/O2), U38.13 (I/O2); also elsewhere on the board
D2: U9.11 (03), U10.11 (03), U11.11 (03), U12.11 (03), U31.12 (I/O3), U32.12 (I/O3), U33.12 (I/O3), U34.12 (I/O3), U35.12 (I/O3), U36.12 (I/O3), U37.12 (I/O3), U38.12 (I/O3); also elsewhere on the board
D3: U9.13 (04), U10.13 (04), U11.13 (04), U12.13 (04), U31.11 (I/O4), U32.11 (I/O4), U33.11 (I/O4), U34.11 (I/O4), U35.11 (I/O4), U36.11 (I/O4), U37.11 (I/O4), U38.11 (I/O4); also elsewhere on the board
D4: U9.14 (05), U10.14 (05), U11.14 (05), U12.14 (05), U45.14 (I/O1), U46.14 (I/O1), U47.14 (I/O1), U48.14 (I/O1), U49.14 (I/O1), U50.14 (I/O1), U51.14 (I/O1), U52.14 (I/O1); also elsewhere on the board
D5: U9.15 (06), U10.15 (06), U11.15 (06), U12.15 (06), U45.13 (I/O2), U46.13 (I/O2), U47.13 (I/O2), U48.13 (I/O2), U49.13 (I/O2), U50.13 (I/O2), U51.13 (I/O2), U52.13 (I/O2); also elsewhere on the board
D6: U9.16 (07), U10.16 (07), U11.16 (07), U12.16 (07), U45.12 (I/O3), U46.12 (I/O3), U47.12 (I/O3), U48.12 (I/O3), U49.12 (I/O3), U50.12 (I/O3), U51.12 (I/O3), U52.12 (I/O3); also elsewhere on the board
D7: U9.17 (08), U10.17 (08), U11.17 (08), U12.17 (08), U45.11 (I/O4), U46.11 (I/O4), U47.11 (I/O4), U48.11 (I/O4), U49.11 (I/O4), U50.11 (I/O4), U51.11 (I/O4), U52.11 (I/O4); also elsewhere on the board
GND: JP28.1 (A), JP31.1 (A), U22.8 (GND), U23.4 (G2A), U23.5 (G2B), U31.9 (GND), U32.9 (GND), U33.9 (GND), U34.9 (GND), U35.9 (GND), U36.9 (GND), U37.9 (GND), U38.9 (GND), U45.9 (GND), U46.9 (GND), U47.9 (GND), U48.9 (GND), U49.9 (GND), U50.9 (GND), U51.9 (GND), U52.9 (GND); also elsewhere on the board
unnamed: JP12.2 (B), U73.1 (A)
unnamed: JP13.2 (B), U73.2 (B)
unnamed: JP26.2 (B), JP27.2 (B), JP28.2 (B), U9.18 (~CE2), U10.18 (~CE2), U11.18 (~CE2), U12.18 (~CE2)
unnamed: JP29.2 (B), JP30.2 (B), JP31.2 (B), U9.21 (CE3), U10.21 (CE3), U11.21 (CE3), U12.21 (CE3)
unnamed: U10.20 (~CE1), U73.13 (Y2)
unnamed: U11.20 (~CE1), U73.14 (Y1)
unnamed: U12.20 (~CE1), U73.15 (Y0)
unnamed: U15.1, U16.1, U19.2 (1B)
unnamed: U15.3, U23.7 (Y7)
unnamed: U16.2, U17.15 (E)
unnamed: U22.4 (E1), U23.15 (Y0)
unnamed: U22.7 (O7), U31.8 (~CS), U45.8 (~CS)
unnamed: U22.9 (O6), U32.8 (~CS), U46.8 (~CS)
unnamed: U22.10 (O5), U33.8 (~CS), U47.8 (~CS)
unnamed: U22.11 (O4), U34.8 (~CS), U48.8 (~CS)
unnamed: U22.12 (O3), U35.8 (~CS), U49.8 (~CS)
unnamed: U22.13 (O2), U36.8 (~CS), U50.8 (~CS)
unnamed: U22.14 (O1), U37.8 (~CS), U51.8 (~CS)
unnamed: U22.15 (O0), U38.8 (~CS), U52.8 (~CS)
unnamed: U23.10 (Y5), U73.5 (G2B)
unnamed: U9.20 (~CE1), U73.12 (Y3)
R/~W: U19.5 (1D), U31.10 (~WE), U32.10 (~WE), U33.10 (~WE), U34.10 (~WE), U35.10 (~WE), U36.10 (~WE), U37.10 (~WE), U38.10 (~WE), U45.10 (~WE), U46.10 (~WE), U47.10 (~WE), U48.10 (~WE), U49.10 (~WE), U50.10 (~WE), U51.10 (~WE), U52.10 (~WE); also elsewhere on the board
~A10: U22.1 (A0); also elsewhere on the board
~A11: JP12.1 (A), U22.2 (A1); also elsewhere on the board
~A12: JP13.1 (A), U15.2, U22.3 (A2); also elsewhere on the board
~ACS: U17.12 (O0); also elsewhere on the board
~MCS: U19.6 (1Y); also elsewhere on the board
~R/W: U73.3 (C); also elsewhere on the board
~V: U23.9 (Y6); also elsewhere on the board
~Φ2: U22.5 (E2), U73.4 (G2A); also elsewhere on the board

Notes on the sheet:
To enable BK0/BK1 open JP12 and JP13, run jumper wire to ~{BK0} and ~{BK1} pins
8kB RAM 16x 1Kx4
The original schematics allow you to choose the polarity of the CE lines. On the PCB the inverters are NOT connected, and it's too crowded to add jumpers.
BASIC ROM 4x 2Kx8
inverted!
Original switched +5V (default) and A12
* Jumper config shown for 2716 (combined called JP10 and JP11 on the PCB)
Original switched +5V (default) and A11

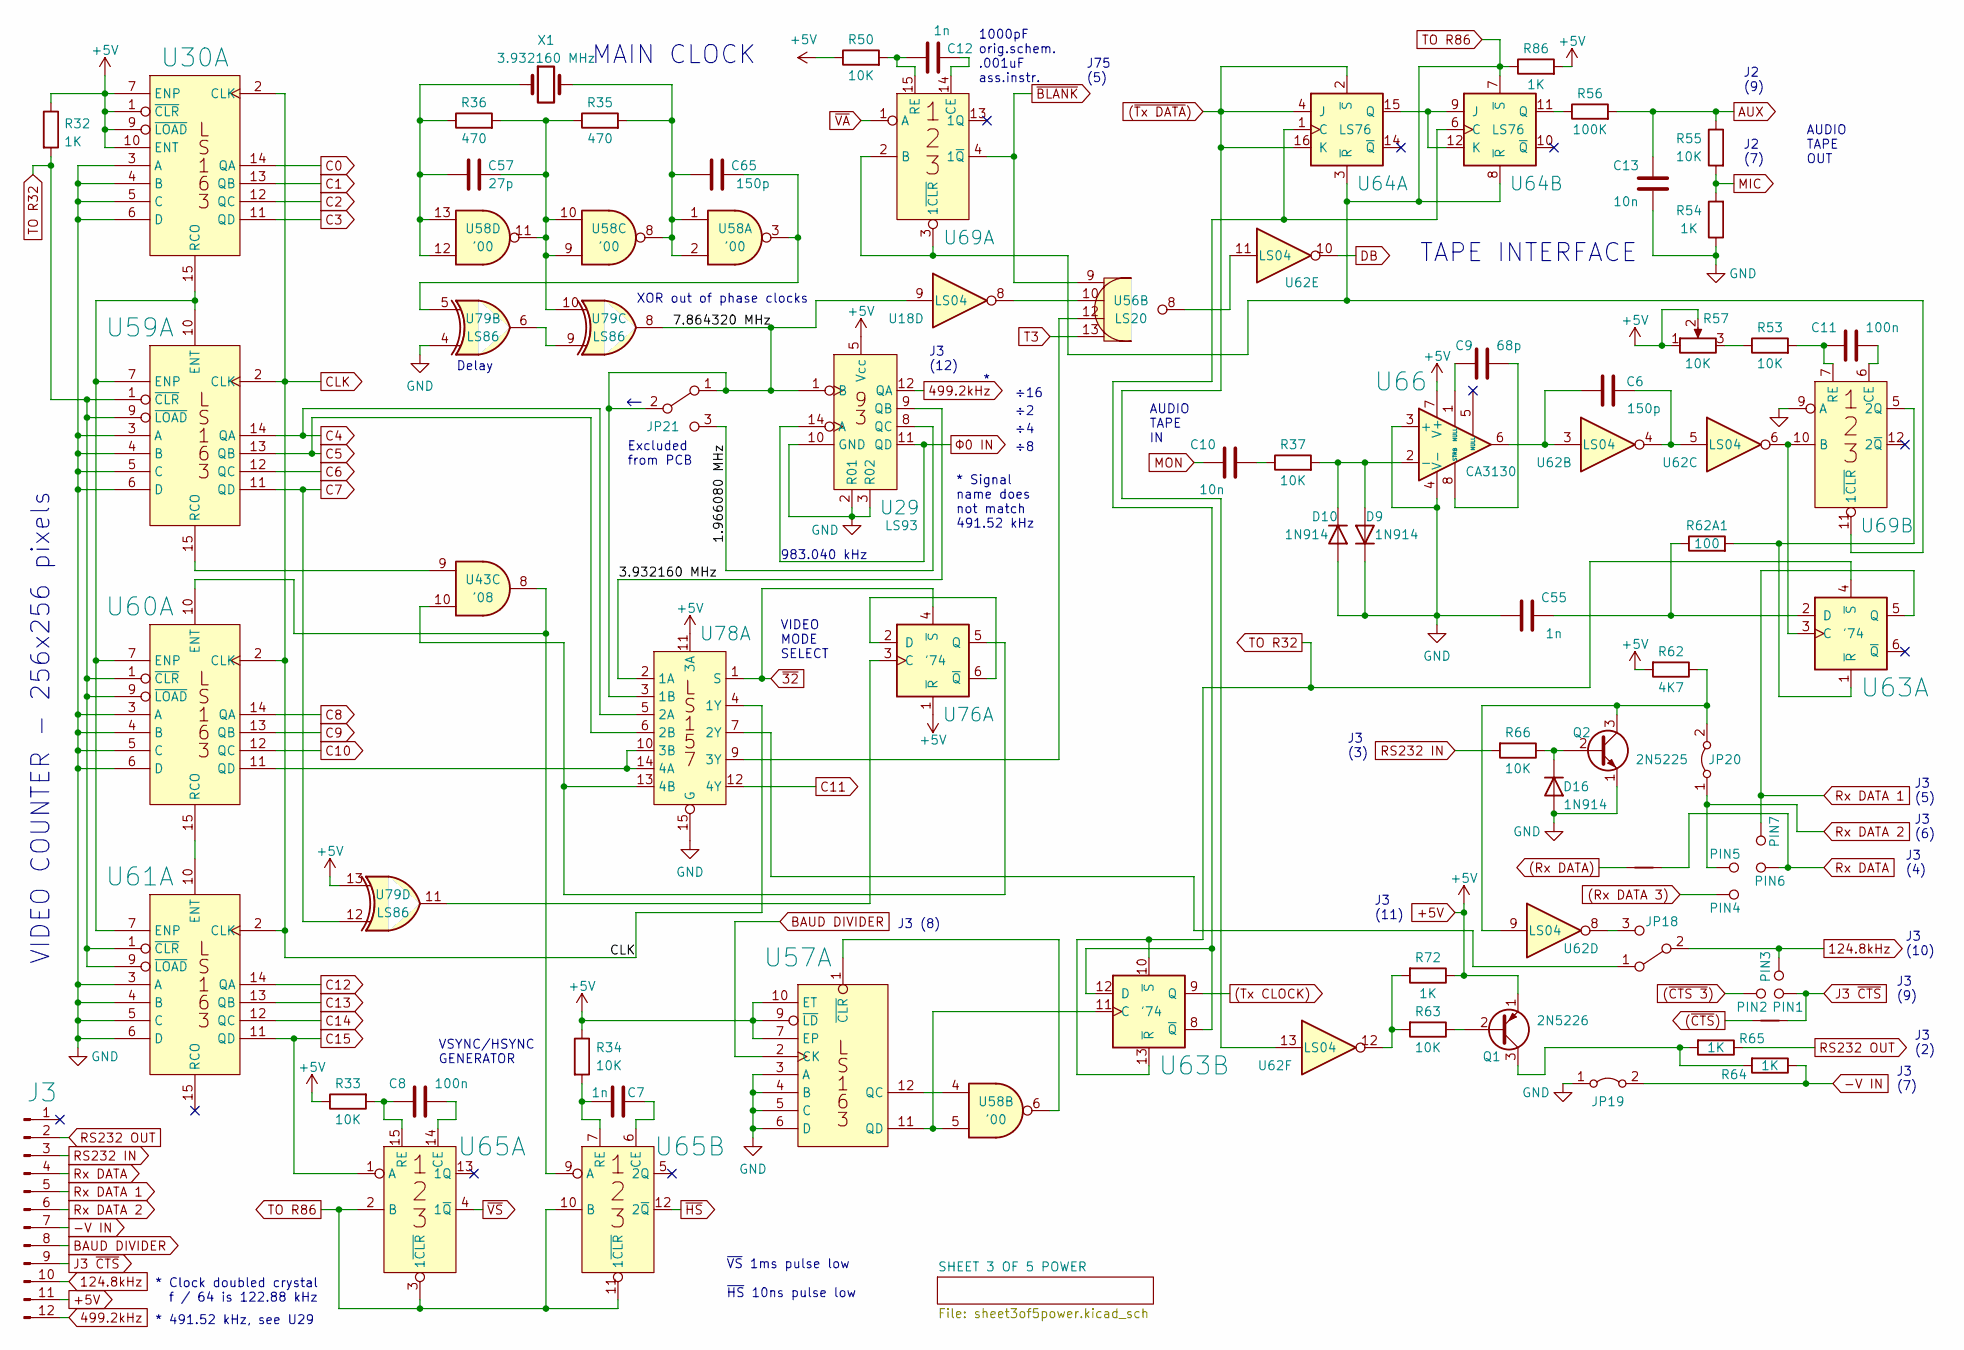
[picture p24: schematic sheet3of5.kicad_sch, SUPERBOARD 2 MODEL 600 REV. D]

Parts:
C6, C65: 150p; C_Disc_D7.5mm_W2.5mm_P7.50mm
C7, C12, C55: 1n; C_Disc_D7.5mm_W2.5mm_P7.50mm
C8: 100n; C_Disc_D5.1mm_W3.2mm_P5.00mm
C9: 68p; C_Disc_D7.5mm_W2.5mm_P7.50mm
C10, C13: 10n; C_Disc_D7.5mm_W2.5mm_P7.50mm
C11: 100n; C_Disc_D7.5mm_W2.5mm_P7.50mm
C57: 27p; C_Disc_D4.3mm_W1.9mm_P5.00mm
D9, D10: 1N914; D_DO-35_SOD27_P10.16mm_Horizontal
D16: 1N914; D_DO-35_SOD27_P5.08mm_Vertical_KathodeUp
J3: Conn_01x12_Male; Molex_KK-396_A-41791-0012_1x12_P3.96mm_Vertical
JP18, JP21: JUMPER; PinHeader_1x03_P2.54mm_Vertical
JP19, JP20: Jumper_2_Bridged; Closed_PinHeader_1x02_P2.54mm_Vertical
NT1, NT2: NetTie_2; NetTie-2_SMD_Pad0.5mm
PIN1, PIN2, PIN3, PIN4, PIN5, PIN6, PIN7: JUMPER_PIN; PinHeader_1x01_P2.54mm_Vertical
Q1: 2N5226; TO-92_Inline_Wide
Q2: 2N5225; TO-92_Inline_Wide
R32, R54, R72, R86: 1K; R_Axial_DIN0207_L6.3mm_D2.5mm_P2.54mm_Vertical
R33, R34, R50, R53, R55, R63, R66: 10K; R_Axial_DIN0207_L6.3mm_D2.5mm_P2.54mm_Vertical
R35, R36: 470; R_Axial_DIN0207_L6.3mm_D2.5mm_P2.54mm_Vertical
R37: 10K; R_Axial_DIN0207_500mils_Horizontal
R56: 100K; R_Axial_DIN0207_L6.3mm_D2.5mm_P2.54mm_Vertical
R57: 10K; Potentiometer_Bourns_3296W_Vertical
R62: 4K7; R_Axial_DIN0207_L6.3mm_D2.5mm_P2.54mm_Vertical
R62A1: 100; R_Axial_DIN0207_L6.3mm_D2.5mm_P2.54mm_Vertical
R64, R65: 1K; R_Axial_DIN0309_L9.0mm_D3.2mm_P20.32mm_Horizontal
U18, U62: LS04; DIP-14_W7.62mm_Socket_LongPads
U29: LS93; DIP-14_W7.62mm_Socket_LongPads
U30, U57, U59, U60, U61: LS163; DIP-16_W7.62mm_Socket_LongPads
U43: '08; DIP-14_W7.62mm_Socket_LongPads
U56: LS20; DIP-14_W7.62mm_Socket_LongPads
U58: '00; DIP-14_W7.62mm_Socket_LongPads
U63, U76: '74; DIP-14_W7.62mm_Socket_LongPads
U64: LS76; DIP-16_W7.62mm_Socket_LongPads
U65, U69: '123; DIP-16_W7.62mm_Socket_LongPads
U66: CA3130; DIP-8_W7.62mm_Socket_LongPads
U78: LS157; DIP-16_W7.62mm_Socket_LongPads
U79: LS86; DIP-14_W7.62mm_Socket_LongPads
X1: 3.932160 MHz; Crystal_HC49-U_Horizontal

Connections:
124.8kHz: J3.10, JP18.2, PIN3.1
499.2kHz: J3.12, U29.12 (QA)
(Rx DATA 3): PIN4.1; also elsewhere on the board
(Rx DATA): NT2.1; also elsewhere on the board
(Tx CLOCK): U63.9 (Q); also elsewhere on the board
(~CTS 3): PIN2.1; also elsewhere on the board
(~CTS): NT1.1; also elsewhere on the board
(~Tx DATA): U62.13, U64.2 (~S), U64.4 (J), U64.16 (K); also elsewhere on the board
+5V: J3.11, Q1.1 (E), R32.1, R33.1, R34.1, R50.1, R57.1, R57.2, R62.2, R72.1, R86.2, U29.5 (Vcc), U30.1 (~CLR), U30.7 (ENP), U30.9 (~LOAD), U30.10 (ENT), U57.7 (EP), U57.9 (~LD), U57.10 (ET), U66.7 (V+), U76.1 (~R), U78.11 (3A), U79.13; also elsewhere on the board
-V IN: J3.7, JP19.2 (B), R64.1
/SHEET 3 OF 5/1.966080 MHz: JP21.3, U29.8 (QC)
/SHEET 3 OF 5/3.932160 MHz: U29.9 (QB), U78.2 (1A)
/SHEET 3 OF 5/7.864320 MHz: JP21.1, JP21.2, U18.9, U29.1 (B), U78.3 (1B), U79.8
AUX: C13.2, R55.1, R56.2; also elsewhere on the board
BAUD DIVIDER: J3.8, U57.2 (CK)
C0: U30.14 (QA); also elsewhere on the board
C1: U30.13 (QB); also elsewhere on the board
C2: U30.12 (QC); also elsewhere on the board
C3: U30.11 (QD); also elsewhere on the board
C4: U59.14 (QA), U78.5 (2A); also elsewhere on the board
C5: U59.13 (QB), U78.6 (2B); also elsewhere on the board
C6: U59.12 (QC); also elsewhere on the board
C7: U59.11 (QD), U79.12; also elsewhere on the board
C8: U60.14 (QA); also elsewhere on the board
C9: U60.13 (QB); also elsewhere on the board
C10: U60.12 (QC); also elsewhere on the board
C11: U78.12 (4Y); also elsewhere on the board
C12: U61.14 (QA); also elsewhere on the board
C13: U61.13 (QB); also elsewhere on the board
C14: U61.12 (QC); also elsewhere on the board
C15: U61.11 (QD), U65.1 (A); also elsewhere on the board
CLK: U30.2 (CLK), U59.2 (CLK), U60.2 (CLK), U61.2 (CLK), U78.4 (1Y); also elsewhere on the board
DB: U62.10; also elsewhere on the board
GND: C13.1, C55.1, D9.1 (K), D10.2 (A), D16.2 (A), JP19.1 (A), Q2.1 (E), R54.1, U29.2 (R01), U29.3 (R02), U29.10 (GND), U30.3 (A), U30.4 (B), U30.5 (C), U30.6 (D), U57.3 (A), U57.4 (B), U57.5 (C), U57.6 (D), U59.3 (A), U59.4 (B), U59.5 (C), U59.6 (D), U60.3 (A), U60.4 (B), U60.5 (C), U60.6 (D), U61.3 (A), U61.4 (B), U61.5 (C), U61.6 (D), U66.3 (+), U66.4 (V-), U69.9 (A), U78.15 (G), U79.4; also elsewhere on the board
J3 ~CTS: J3.9, NT1.2, PIN1.1
MIC: R54.2, R55.2; also elsewhere on the board
MON: C10.1; also elsewhere on the board
unnamed: C6.1, U62.3, U66.6
unnamed: C6.2, U62.4, U62.5
unnamed: C7.1, R34.2, U65.7 (RE)
unnamed: C7.2, U65.6 (CE)
unnamed: C8.1, R33.2, U65.15 (RE)
unnamed: C8.2, U65.14 (CE)
unnamed: C9.1, U66.1 (NULL)
unnamed: C9.2, U66.8 (STRB)
unnamed: C10.2, R37.1
unnamed: C11.1, R53.2, U69.7 (RE)
unnamed: C11.2, U69.6 (CE)
unnamed: C12.1, R50.2, U69.15 (RE)
unnamed: C12.2, U69.14 (CE)
unnamed: C55.2, R62A1.1, U63.2 (D)
unnamed: C57.1, R36.1, U58.12, U58.13, X1.1
unnamed: C57.2, R35.1, R36.2, U58.9, U58.10, U58.11, U79.10
unnamed 106: C65.1, R35.2, U58.1, U58.2, U58.8, X1.2; also elsewhere on the board
unnamed: C65.2, U58.3, U79.5
unnamed: D9.2 (A), D10.1 (K), R37.2, U66.2 (-)
unnamed: D16.1 (K), Q2.2 (B), R66.1
unnamed: JP18.1, U78.7 (2Y)
unnamed: JP18.3, U62.8
unnamed: JP20.2 (B), Q2.3 (C), R62.1, U62.9
unnamed: Q1.2 (B), R63.1
unnamed: Q1.3 (C), R64.2, R65.2
unnamed: R53.1, R57.3
unnamed: R56.1, U64.11 (Q)
unnamed: R62A1.2, U63.1 (~R), U69.5 (2Q)
unnamed: R63.2, R72.2, U62.12
unnamed: U18.8, U56.10 (2B)
unnamed: U30.15 (RCO), U59.7 (ENP), U59.10 (ENT), U60.7 (ENP), U61.7 (ENP)
unnamed: U43.8, U60.10 (ENT), U65.9 (A)
unnamed: U43.9, U59.15 (RCO)
unnamed: U43.10, U76.5 (Q), U78.13 (4B)
unnamed: U56.8 (2Y), U62.11
unnamed: U56.12 (2C), U78.9 (3Y)
unnamed: U57.1 (~CLR), U58.6
unnamed: U57.11 (QD), U58.5, U63.11 (C)
unnamed: U57.12 (QC), U58.4
unnamed: U60.11 (QD), U78.10 (3B), U78.14 (4A)
unnamed: U60.15 (RCO), U61.10 (ENT)
unnamed: U62.6, U63.3 (C), U69.10 (B)
unnamed: U63.8 (~Q), U63.12 (D), U64.1 (C), U64.6 (C)
unnamed: U64.9 (J), U64.12 (K), U64.15 (Q)
unnamed: U76.2 (D), U76.6 (~Q)
unnamed: U76.3 (C), U79.11
unnamed: U79.6, U79.9
RS232 IN: J3.3, R66.2
RS232 OUT: J3.2, R65.1
Rx DATA: J3.4, NT2.2, PIN6.1
Rx DATA 1: J3.5, PIN7.1, U63.5 (Q)
Rx DATA 2: J3.6, JP20.1 (A), PIN5.1
T3: U56.13 (2D); also elsewhere on the board
TO R32: R32.2, U59.1 (~CLR), U59.9 (~LOAD), U60.1 (~CLR), U60.9 (~LOAD), U61.1 (~CLR), U61.9 (~LOAD), U63.4 (~S), U63.10 (~S), U63.13 (~R)
TO R86: R86.1, U64.3 (~R), U64.7 (~S), U64.8 (~R), U65.2 (B), U65.3 (1~CLR), U65.10 (B), U65.11 (1~CLR), U69.2 (B), U69.3 (1~CLR), U69.11 (1~CLR)
~32: U76.4 (~S), U78.1 (S); also elsewhere on the board
~BLANK: U56.9 (2A), U69.4 (1~Q); also elsewhere on the board
~HS: U65.12 (2~Q); also elsewhere on the board
~VA: U69.1 (A); also elsewhere on the board
~VS: U65.4 (1~Q); also elsewhere on the board
Φ0 IN: U29.11 (QD), U29.14 (A); also elsewhere on the board

Notes on the sheet:
J3 (4)
J3 (5)
J3 (7)
983.040 kHz
J3 (10)
J3 (2)
Delay
* Signal name does not match 491.52 kHz
J2 (7)
XOR out of phase clocks
* 491.52 kHz, see U29
J75 (5)
J3 (6)
÷16
AUDIO TAPE OUT
J3 (11)
1000pF orig.schem. .001uF ass.instr.
J3 (12)
VSYNC/HSYNC GENERATOR
* Clock doubled crystal f / 64 is 122.88 kHz
VIDEO MODE SELECT
J3 (8)
TAPE INTERFACE
~{VS} 1ms pulse low ~{HS} 10ns pulse low
J2 (9)
AUDIO TAPE IN
Excluded from PCB
J3 (9)
VIDEO COUNTER - 256x256 pixels
J3 (3)
MAIN CLOCK
