ivop/osi600d/kicad/OSI600D.kicad_pcb

## KiCad design kicad/OSI600D.kicad_pcb (continued)

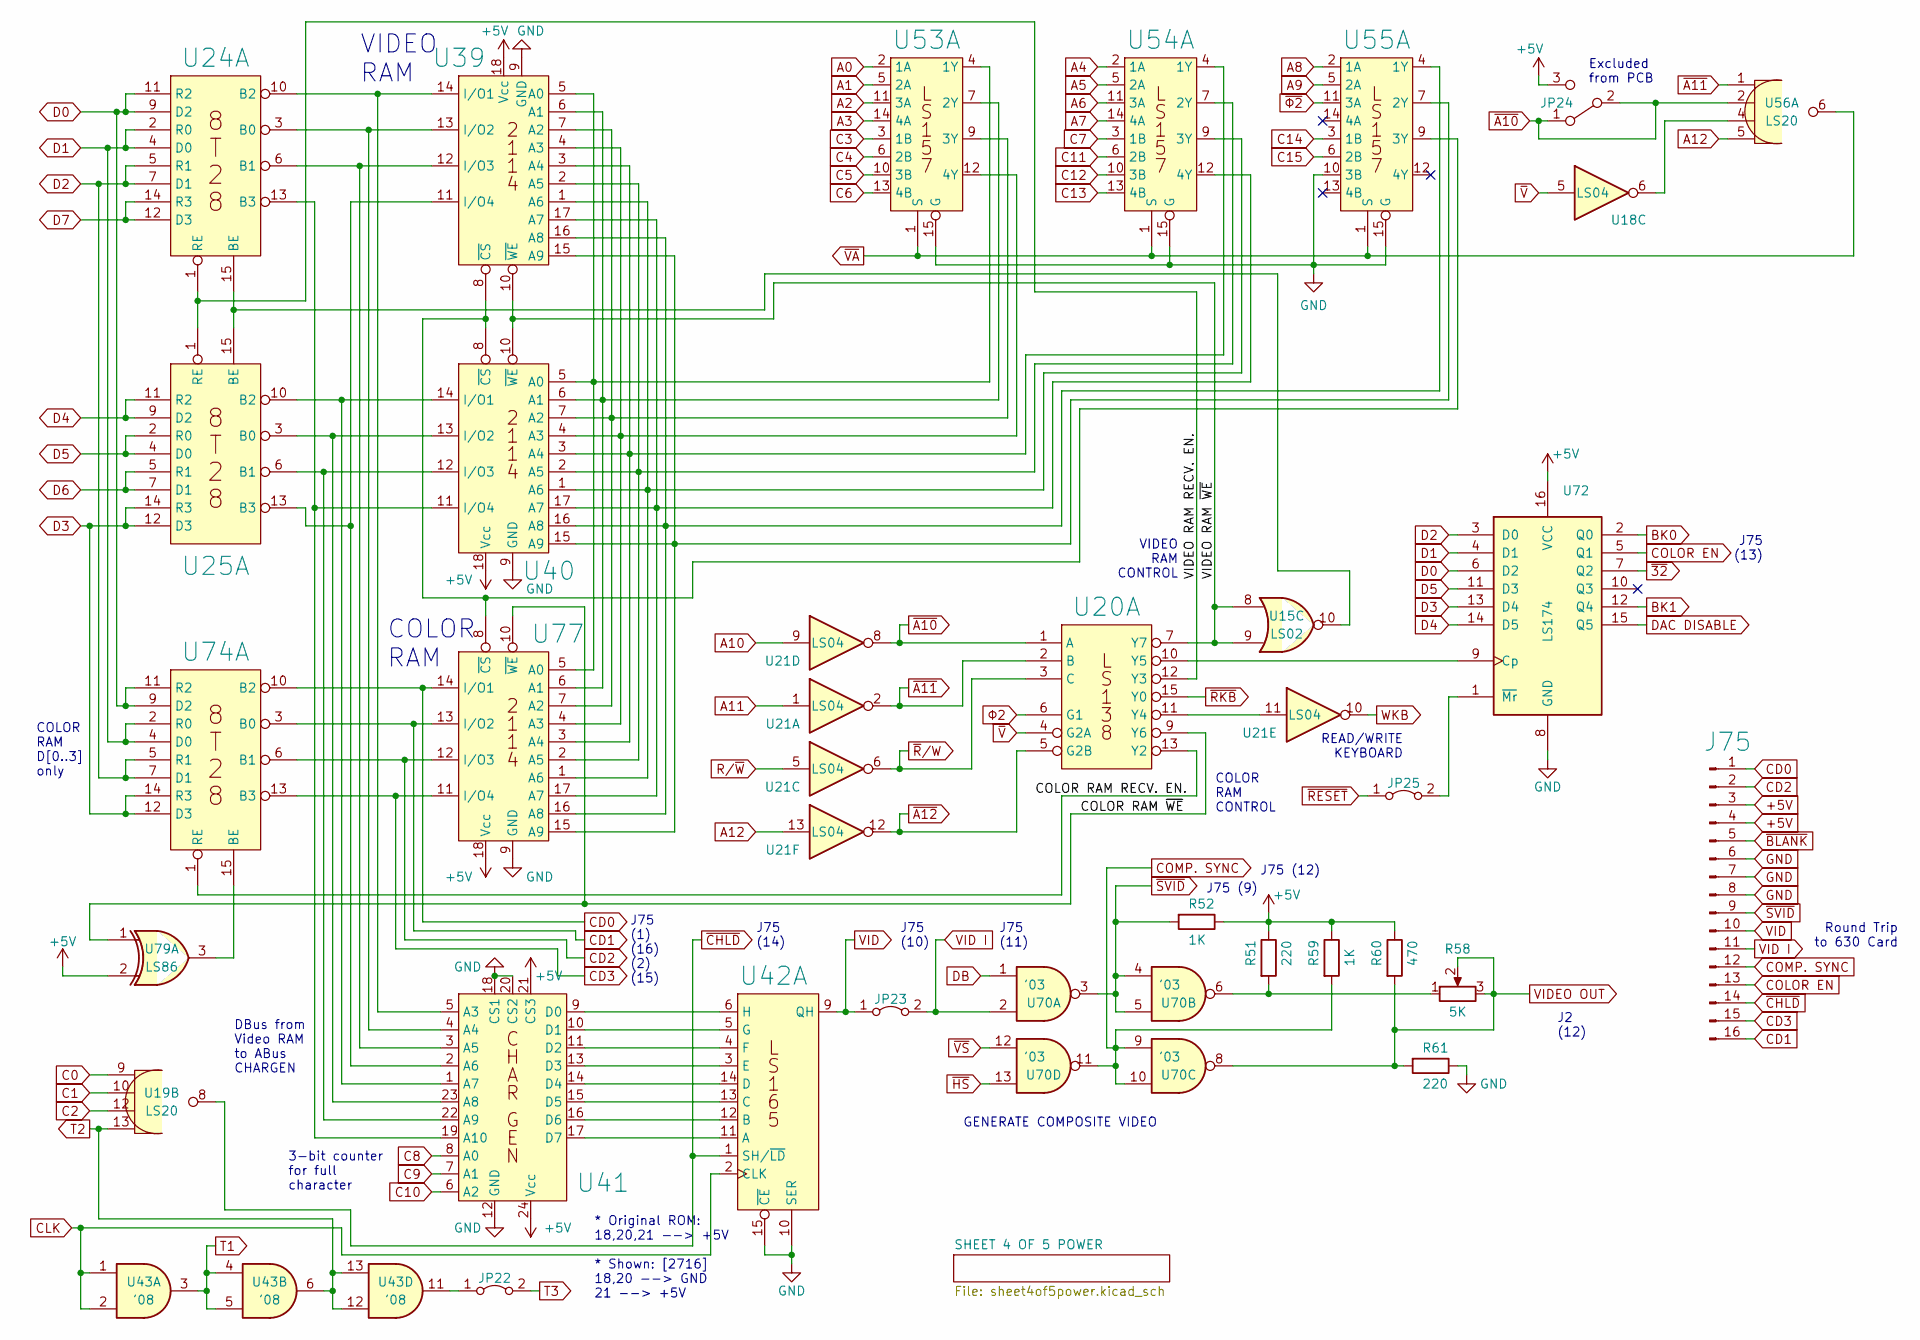
[picture p25: schematic sheet4of5.kicad_sch, SUPERBOARD 2 MODEL 600 REV. D]

Parts:
J75: Conn_01x16_Male; DIP-16_W7.62mm_Socket_LongPads
JP22, JP23, JP25: Jumper_2_Bridged; Closed_PinHeader_1x02_P2.54mm_Vertical
JP24: JUMPER; PinHeader_1x03_P2.54mm_Vertical
R51, R61: 220; R_Axial_DIN0207_L6.3mm_D2.5mm_P2.54mm_Vertical
R52, R59: 1K; R_Axial_DIN0207_L6.3mm_D2.5mm_P2.54mm_Vertical
R58: 5K; Potentiometer_Bourns_3296W_Vertical
R60: 470; R_Axial_DIN0207_L6.3mm_D2.5mm_P2.54mm_Vertical
U15: LS02; DIP-14_W7.62mm_Socket_LongPads
U18, U21: LS04; DIP-14_W7.62mm_Socket_LongPads
U19, U56: LS20; DIP-14_W7.62mm_Socket_LongPads
U20: LS138; DIP-16_W7.62mm_Socket_LongPads
U24, U25, U74: 8T28; DIP-16_W7.62mm_Socket_LongPads
U39: 2114 CS BOTTOM COMPACT; DIP-18_W7.62mm_Socket_LongPads
U40, U77: 2114 CS TOP COMPACT; DIP-18_W7.62mm_Socket_LongPads
U41: CHARGEN; DIP-24_W15.24mm_Socket_LongPads
U42: LS165; DIP-16_W7.62mm_Socket_LongPads
U43: '08; DIP-14_W7.62mm_Socket_LongPads
U53, U54, U55: LS157; DIP-16_W7.62mm_Socket_LongPads
U70: '03; DIP-14_W7.62mm_Socket_LongPads
U72: LS174; DIP-16_W7.62mm_Socket_LongPads
U79: LS86; DIP-14_W7.62mm_Socket_LongPads

Connections:
+5V: J75.3, J75.4, JP24.3, R51.1, R52.1, R59.1, R60.1, U39.18 (Vcc), U40.18 (Vcc), U41.21 (CS3), U41.24 (Vcc), U72.16 (VCC), U77.18 (Vcc), U79.2; also elsewhere on the board
/SHEET 4 OF 5/COLOR RAM RECV. EN.: U20.13 (Y2), U74.1 (RE)
/SHEET 4 OF 5/COLOR RAM ~WE: U20.9 (Y6), U77.10 (~WE), U79.1
/SHEET 4 OF 5/VIDEO RAM RECV. EN.: U20.12 (Y3), U24.1 (RE), U25.1 (RE)
/SHEET 4 OF 5/VIDEO RAM ~WE: U15.8, U15.9, U20.7 (Y7), U39.10 (~WE), U40.10 (~WE)
A0: U53.2 (1A); also elsewhere on the board
A1: U53.5 (2A); also elsewhere on the board
A2: U53.11 (3A); also elsewhere on the board
A3: U53.14 (4A); also elsewhere on the board
A4: U54.2 (1A); also elsewhere on the board
A5: U54.5 (2A); also elsewhere on the board
A6: U54.11 (3A); also elsewhere on the board
A7: U54.14 (4A); also elsewhere on the board
A8: U55.2 (1A); also elsewhere on the board
A9: U55.5 (2A); also elsewhere on the board
A10: U21.9; also elsewhere on the board
A11: U21.1; also elsewhere on the board
A12: U21.13, U56.5 (1D); also elsewhere on the board
BK0: U72.2 (Q0); also elsewhere on the board
BK1: U72.12 (Q4); also elsewhere on the board
C0: U19.9 (2A); also elsewhere on the board
C1: U19.10 (2B); also elsewhere on the board
C2: U19.12 (2C); also elsewhere on the board
C3: U53.3 (1B); also elsewhere on the board
C4: U53.6 (2B); also elsewhere on the board
C5: U53.10 (3B); also elsewhere on the board
C6: U53.13 (4B); also elsewhere on the board
C7: U54.3 (1B); also elsewhere on the board
C8: U41.8 (A0); also elsewhere on the board
C9: U41.7 (A1); also elsewhere on the board
C10: U41.6 (A2); also elsewhere on the board
C11: U54.6 (2B); also elsewhere on the board
C12: U54.10 (3B); also elsewhere on the board
C13: U54.13 (4B); also elsewhere on the board
C14: U55.3 (1B); also elsewhere on the board
C15: U55.6 (2B); also elsewhere on the board
CD0: J75.1, U74.10 (B2), U77.14 (I/O1)
CD1: J75.16, U74.3 (B0), U77.13 (I/O2)
CD2: J75.2, U74.6 (B1), U77.12 (I/O3)
CD3: J75.15, U74.13 (B3), U77.11 (I/O4)
CLK: U42.2 (CLK), U43.1, U43.2; also elsewhere on the board
COLOR EN: J75.13, U72.5 (Q1)
COMP. SYNC: J75.12, R59.2, U70.9, U70.10, U70.11
D0: U24.9 (D2), U24.11 (R2), U72.6 (D2), U74.9 (D2), U74.11 (R2); also elsewhere on the board
D1: U24.2 (R0), U24.4 (D0), U72.4 (D1), U74.2 (R0), U74.4 (D0); also elsewhere on the board
D2: U24.5 (R1), U24.7 (D1), U72.3 (D0), U74.5 (R1), U74.7 (D1); also elsewhere on the board
D3: U25.12 (D3), U25.14 (R3), U72.13 (D4), U74.12 (D3), U74.14 (R3); also elsewhere on the board
D4: U25.9 (D2), U25.11 (R2), U72.14 (D5); also elsewhere on the board
D5: U25.2 (R0), U25.4 (D0), U72.11 (D3); also elsewhere on the board
D6: U25.5 (R1), U25.7 (D1); also elsewhere on the board
D7: U24.12 (D3), U24.14 (R3); also elsewhere on the board
DAC DISABLE: U72.15 (Q5); also elsewhere on the board
DB: U70.1; also elsewhere on the board
GND: J75.6, J75.7, J75.8, R61.1, U39.9 (GND), U40.9 (GND), U41.12 (GND), U41.18 (CS1), U41.20 (CS2), U42.10 (SER), U42.15 (~CE), U53.15 (G), U54.15 (G), U55.10 (3B), U55.15 (G), U72.8 (GND), U77.9 (GND); also elsewhere on the board
unnamed: JP22.1 (A), U43.11
unnamed: JP25.2 (B), U72.1 (~Mr)
unnamed: R51.2, R58.1, U70.6
unnamed: U15.10, U24.15 (BE), U25.15 (BE)
unnamed: U18.6, U56.4 (1C)
unnamed: U20.10 (Y5), U72.9 (Cp)
unnamed: U20.11 (Y4), U21.11
unnamed: U24.3 (B0), U39.13 (I/O2), U41.4 (A4)
unnamed: U24.6 (B1), U39.12 (I/O3), U41.3 (A5)
unnamed: U24.10 (B2), U39.14 (I/O1), U41.5 (A3)
unnamed: U24.13 (B3), U40.11 (I/O4), U41.19 (A10)
unnamed: U25.3 (B0), U40.13 (I/O2), U41.23 (A8)
unnamed: U25.6 (B1), U40.12 (I/O3), U41.22 (A9)
unnamed: U25.10 (B2), U40.14 (I/O1), U41.1 (A7)
unnamed: U25.13 (B3), U39.11 (I/O4), U41.2 (A6)
unnamed: U39.1 (A6), U40.1 (A6), U54.9 (3Y), U77.1 (A6)
unnamed: U39.2 (A5), U40.2 (A5), U54.7 (2Y), U77.2 (A5)
unnamed: U39.3 (A4), U40.3 (A4), U54.4 (1Y), U77.3 (A4)
unnamed: U39.4 (A3), U40.4 (A3), U53.12 (4Y), U77.4 (A3)
unnamed: U39.5 (A0), U40.5 (A0), U53.4 (1Y), U77.5 (A0)
unnamed: U39.6 (A1), U40.6 (A1), U53.7 (2Y), U77.6 (A1)
unnamed: U39.7 (A2), U40.7 (A2), U53.9 (3Y), U77.7 (A2)
unnamed: U39.8 (~CS), U40.8 (~CS), U55.9 (3Y), U77.8 (~CS)
unnamed: U39.15 (A9), U40.15 (A9), U55.7 (2Y), U77.15 (A9)
unnamed: U39.16 (A8), U40.16 (A8), U55.4 (1Y), U77.16 (A8)
unnamed: U39.17 (A7), U40.17 (A7), U54.12 (4Y), U77.17 (A7)
unnamed: U41.9 (D0), U42.6 (H)
unnamed: U41.10 (D1), U42.5 (G)
unnamed: U41.11 (D2), U42.4 (F)
unnamed: U41.13 (D3), U42.3 (E)
unnamed: U41.14 (D4), U42.14 (D)
unnamed: U41.15 (D5), U42.13 (C)
unnamed: U41.16 (D6), U42.12 (B)
unnamed: U41.17 (D7), U42.11 (A)
unnamed: U74.15 (BE), U79.3
R/~W: U21.5; also elsewhere on the board
T1: U43.3, U43.4, U43.5
T2: U19.13 (2D), U43.6, U43.12, U43.13
T3: JP22.2 (B); also elsewhere on the board
VID: J75.10, JP23.1 (A), U42.9 (QH)
VID I: J75.11, JP23.2 (B), U70.2
VIDEO OUT: R58.2, R58.3, R60.2, R61.2, U70.8; also elsewhere on the board
WKB: U21.10; also elsewhere on the board
~32: U72.7 (Q2); also elsewhere on the board
~A10: JP24.1, JP24.2, U20.1 (A), U21.8, U56.2 (1B); also elsewhere on the board
~A11: U20.2 (B), U21.2, U56.1 (1A); also elsewhere on the board
~A12: U20.5 (G2B), U21.12; also elsewhere on the board
~BLANK: J75.5; also elsewhere on the board
~CHLD: J75.14, U19.8 (2Y), U42.1 (SH/~LD)
~HS: U70.13; also elsewhere on the board
~RESET: JP25.1 (A); also elsewhere on the board
~RKB: U20.15 (Y0); also elsewhere on the board
~R/W: U20.3 (C), U21.6; also elsewhere on the board
~SVID: J75.9, R52.2, U70.3, U70.4, U70.5
~VA: U53.1 (S), U54.1 (S), U55.1 (S), U56.6 (1Y); also elsewhere on the board
~VS: U70.12; also elsewhere on the board
~V: U18.5, U20.4 (G2A); also elsewhere on the board
~Φ2: U55.11 (3A); also elsewhere on the board
Φ2: U20.6 (G1); also elsewhere on the board

Notes on the sheet:
VIDEO RAM
Excluded from PCB
COLOR RAM
* Original ROM: 18,20,21 --> +5V * Shown: [2716] 18,20 --> GND 21 --> +5V
J75 (10)
READ/WRITE KEYBOARD
J75 (9)
J75 (14)
J2 (12)
GENERATE COMPOSITE VIDEO
J75 (13)
J75 (11)
3-bit counter for full character
J75 (1) (16) (2) (15)
Round Trip to 630 Card
COLOR RAM D[0..3] only
VIDEO RAM CONTROL
J75 (12)
DBus from Video RAM to ABus CHARGEN
COLOR RAM CONTROL

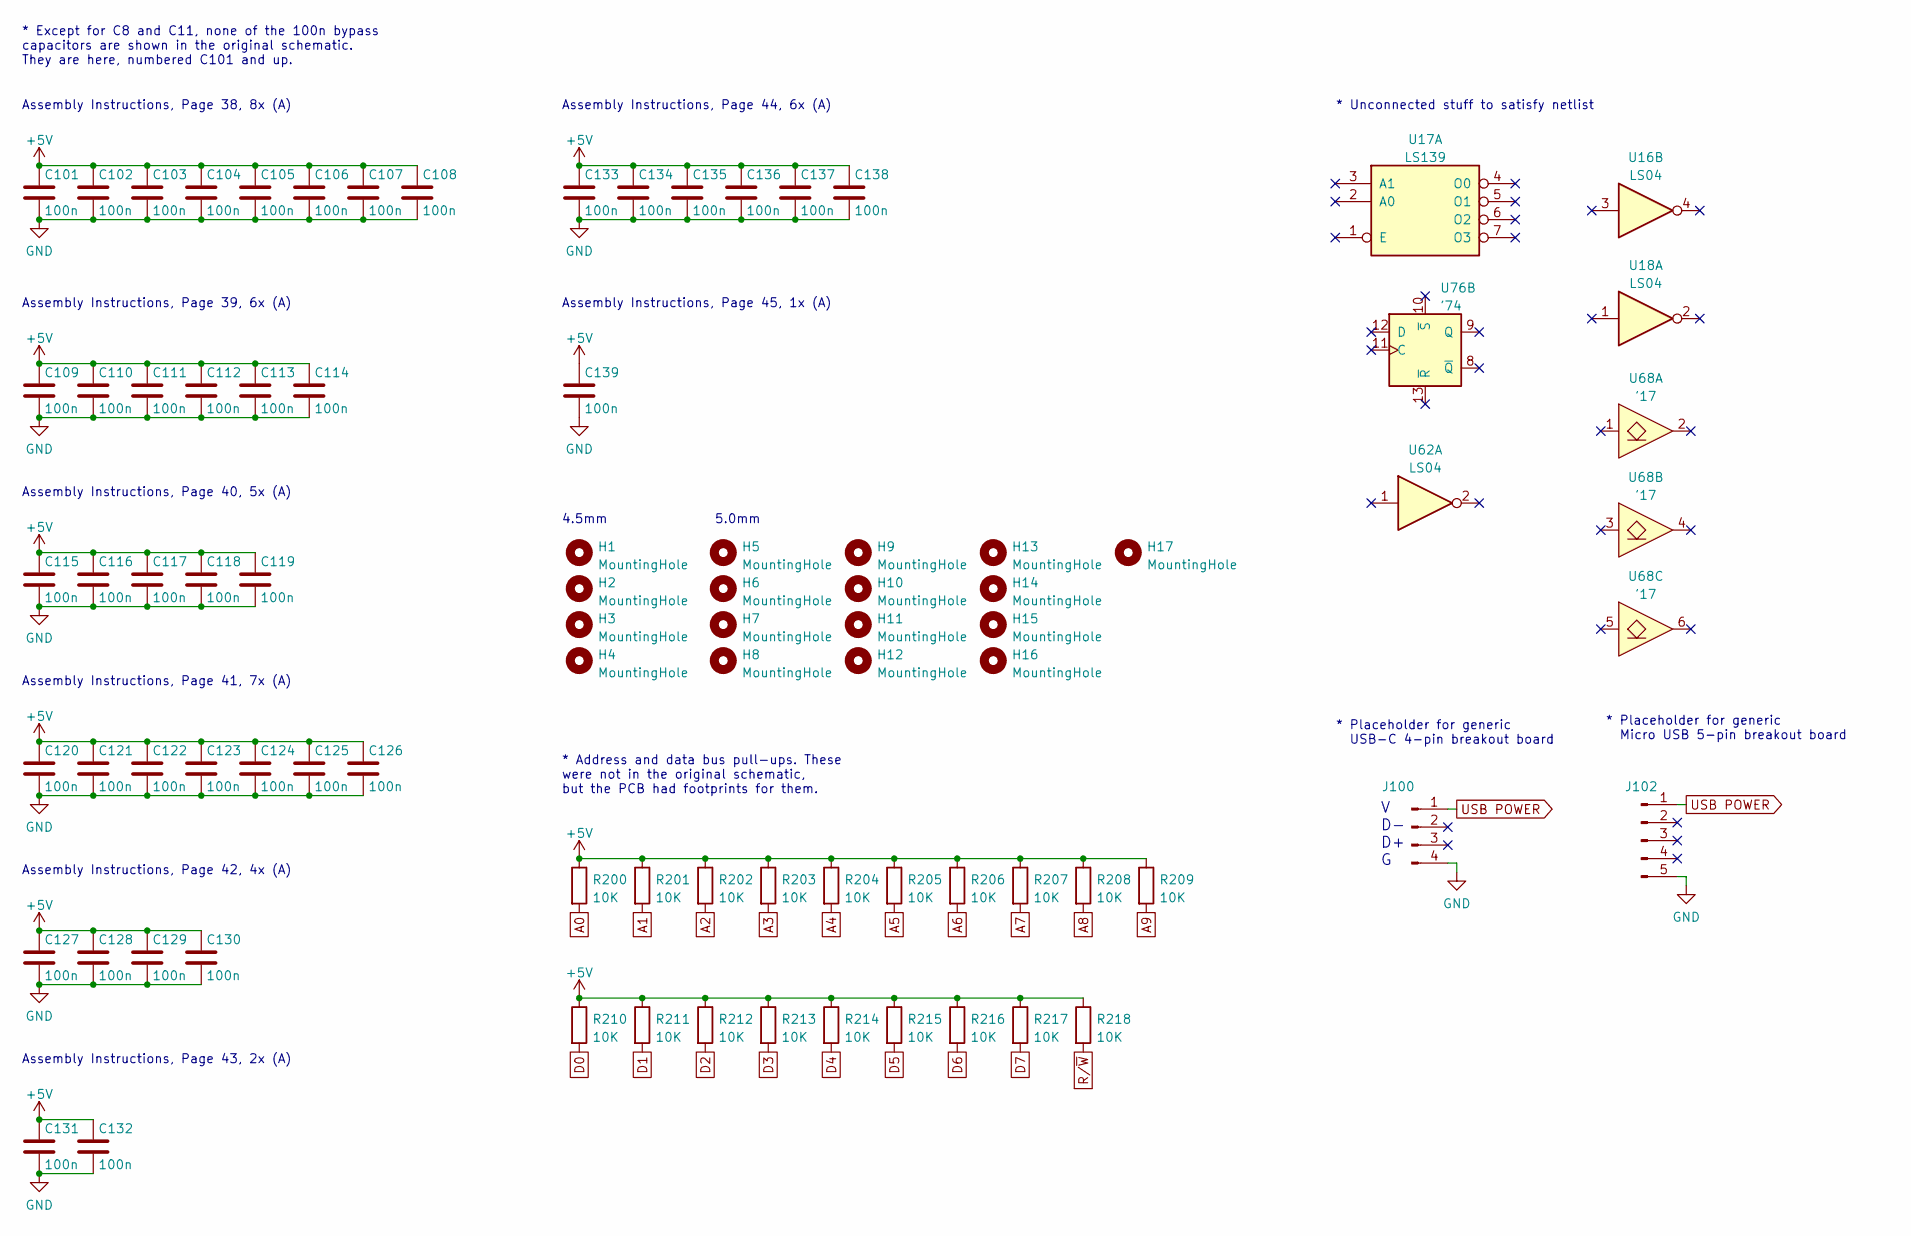
[picture p26: schematic extracomponents.kicad_sch, SUPERBOARD 2 MODEL 600 REV. D]

Parts:
C101, C102, C103, C104, C105, C106, C107, C108, C109, C110, C111, C112, C113, C114, C115, C116, C117, C118, C119, C120, C121, C122, C123, C124, C125, C126, C127, C128, C129, C130, C131, C132, C133, C134, C135, C136, C137, C138, C139: 100n; C_Disc_D7.5mm_W2.5mm_P7.50mm
H1, H2, H3, H4: MountingHole; MountingHole_4.5mm
H5, H6, H7, H8, H9, H10, H11, H12, H13, H14, H15, H16, H17: MountingHole; MountingHole_5mm
J100: USB; PinHeader_1x04_P2.54mm_Vertical
J102: USB; PinHeader_1x05_P2.54mm_Vertical
R200, R201, R202, R203, R204, R205, R206, R207, R208, R209, R210, R211, R212, R213, R214, R215, R216, R217, R218: 10K; R_Axial_DIN0207_L6.3mm_D2.5mm_P2.54mm_Vertical
U16, U18, U62: LS04; DIP-14_W7.62mm_Socket_LongPads
U17: LS139; DIP-16_W7.62mm_Socket_LongPads
U68: '17; DIP-14_W7.62mm_Socket_LongPads
U76: '74; DIP-14_W7.62mm_Socket_LongPads

Connections:
+5V: C101.1, C102.1, C103.1, C104.1, C105.1, C106.1, C107.1, C108.1, C109.1, C110.1, C111.1, C112.1, C113.1, C114.1, C115.1, C116.1, C117.1, C118.1, C119.1, C120.1, C121.1, C122.1, C123.1, C124.1, C125.1, C126.1, C127.1, C128.1, C129.1, C130.1, C131.1, C132.1, C133.1, C134.1, C135.1, C136.1, C137.1, C138.1, C139.1, R200.1, R201.1, R202.1, R203.1, R204.1, R205.1, R206.1, R207.1, R208.1, R209.1, R210.1, R211.1, R212.1, R213.1, R214.1, R215.1, R216.1, R217.1, R218.1; also elsewhere on the board
A0: R200.2; also elsewhere on the board
A1: R201.2; also elsewhere on the board
A2: R202.2; also elsewhere on the board
A3: R203.2; also elsewhere on the board
A4: R204.2; also elsewhere on the board
A5: R205.2; also elsewhere on the board
A6: R206.2; also elsewhere on the board
A7: R207.2; also elsewhere on the board
A8: R208.2; also elsewhere on the board
A9: R209.2; also elsewhere on the board
D0: R210.2; also elsewhere on the board
D1: R211.2; also elsewhere on the board
D2: R212.2; also elsewhere on the board
D3: R213.2; also elsewhere on the board
D4: R214.2; also elsewhere on the board
D5: R215.2; also elsewhere on the board
D6: R216.2; also elsewhere on the board
D7: R217.2; also elsewhere on the board
GND: C101.2, C102.2, C103.2, C104.2, C105.2, C106.2, C107.2, C108.2, C109.2, C110.2, C111.2, C112.2, C113.2, C114.2, C115.2, C116.2, C117.2, C118.2, C119.2, C120.2, C121.2, C122.2, C123.2, C124.2, C125.2, C126.2, C127.2, C128.2, C129.2, C130.2, C131.2, C132.2, C133.2, C134.2, C135.2, C136.2, C137.2, C138.2, C139.2, J100.4, J102.5; also elsewhere on the board
R/~W: R218.2; also elsewhere on the board
USB POWER: J100.1, J102.1; also elsewhere on the board

Notes on the sheet:
* Placeholder for generic USB-C 4-pin breakout board
Assembly Instructions, Page 40, 5x (A)
* Placeholder for generic Micro USB 5-pin breakout board
Assembly Instructions, Page 42, 4x (A)
V D- D+ G
* Unconnected stuff to satisfy netlist
Assembly Instructions, Page 45, 1x (A)
Assembly Instructions, Page 44, 6x (A)
4.5mm
* Address and data bus pull-ups. These were not in the original schematic, but the PCB had footprints for them.
Assembly Instructions, Page 39, 6x (A)
5.0mm
Assembly Instructions, Page 38, 8x (A)
* Except for C8 and C11, none of the 100n bypass capacitors are shown in the original schematic. They are here, numbered C101 and up.
Assembly Instructions, Page 41, 7x (A)
Assembly Instructions, Page 43, 2x (A)

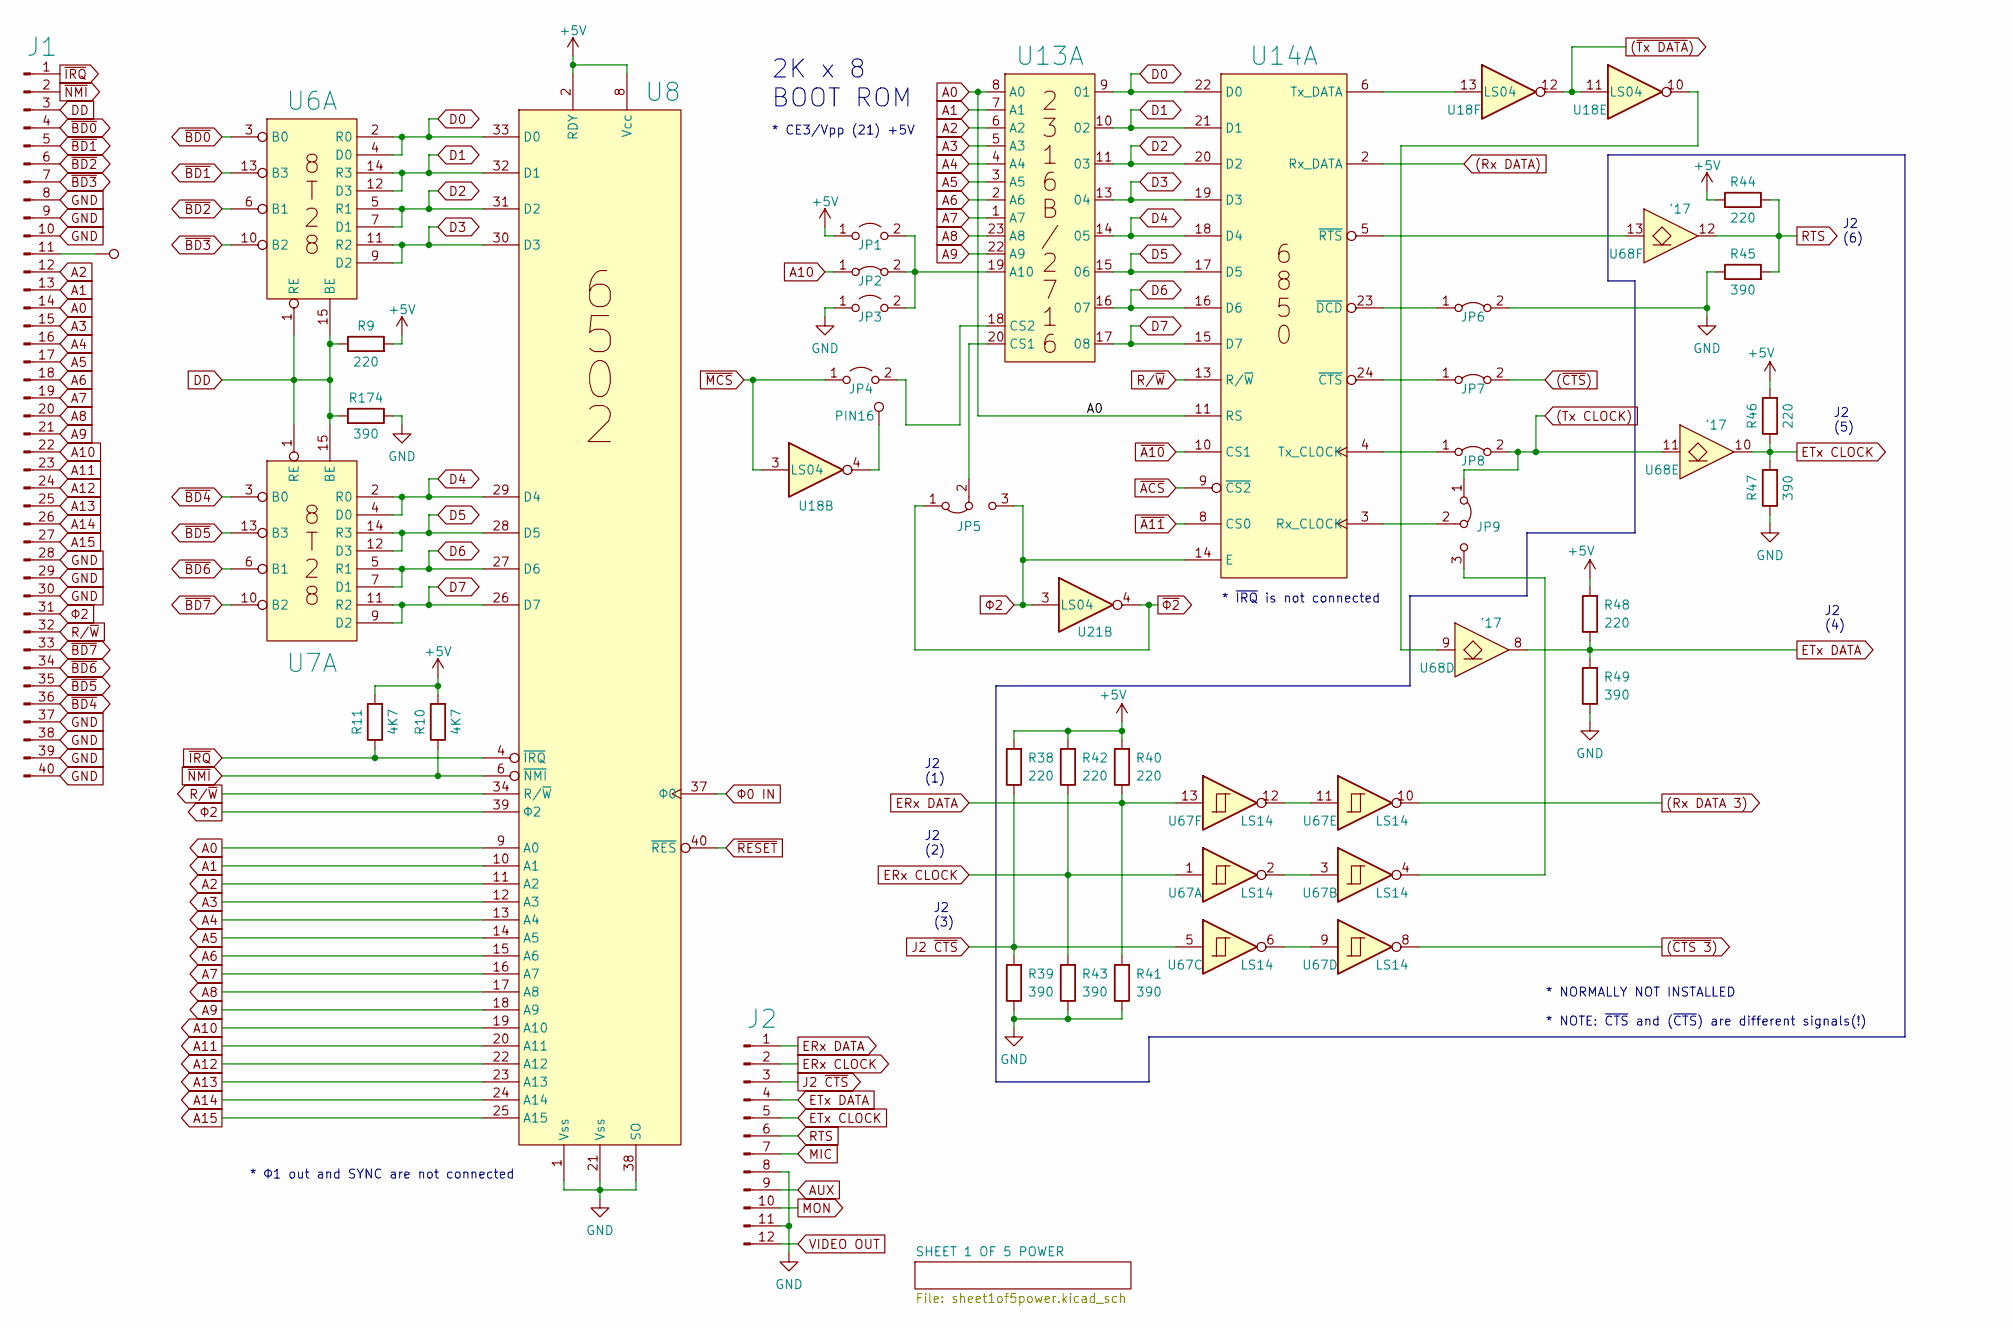
[picture p27: schematic sheet1of5.kicad_sch, SUPERBOARD 2 MODEL 600 REV. D]

Parts:
J1: Conn_01x40_Male; DIP-40_W15.24mm_Socket_LongPads
J2: Conn_01x12_Male; Molex_KK-396_A-41791-0012_1x12_P3.96mm_Vertical
JP1, JP3, JP4: Jumper_2_Open; PinHeader_1x02_P2.54mm_Vertical
JP2, JP6, JP7, JP8: Jumper_2_Bridged; Closed_PinHeader_1x02_P2.54mm_Vertical
JP5, JP9: Jumper_3_Bridged12; Closed 1-2 PinHeader_1x03_P2.54mm_Vertical
PIN15, PIN16: JUMPER_PIN; PinHeader_1x01_P2.54mm_Vertical
R9, R38, R40, R42, R44, R46, R48: 220; R_Axial_DIN0207_L6.3mm_D2.5mm_P2.54mm_Vertical
R10, R11: 4K7; R_Axial_DIN0207_L6.3mm_D2.5mm_P2.54mm_Vertical
R39, R41, R43, R45, R47, R49, R174: 390; R_Axial_DIN0207_L6.3mm_D2.5mm_P2.54mm_Vertical
U6, U7: 8T28; DIP-16_W7.62mm_Socket_LongPads
U8: 6502; DIP-40_W15.24mm_Socket_LongPads
U13: 2316B/2716; DIP-24_W15.24mm_Socket_LongPads
U14: 6850; DIP-24_W15.24mm_Socket_LongPads
U18, U21: LS04; DIP-14_W7.62mm_Socket_LongPads
U67: LS14; DIP-14_W7.62mm_Socket_LongPads
U68: '17; DIP-14_W7.62mm_Socket_LongPads

Connections:
(Rx DATA 3): U67.10; also elsewhere on the board
(Rx DATA): U14.2 (Rx_DATA); also elsewhere on the board
(Tx CLOCK): JP8.2 (B), JP9.1 (A), U68.11 (5A); also elsewhere on the board
(~CTS 3): U67.8; also elsewhere on the board
(~CTS): JP7.2 (B); also elsewhere on the board
(~Tx DATA): U18.11, U18.12; also elsewhere on the board
+5V: JP1.1 (A), R9.2, R10.2, R11.2, R38.2, R40.2, R42.2, R44.2, R46.2, R48.2, U8.2 (RDY), U8.8 (Vcc); also elsewhere on the board
A0: J1.14, U8.9 (A0), U13.8 (A0), U14.11 (RS); also elsewhere on the board
A1: J1.13, U8.10 (A1), U13.7 (A1); also elsewhere on the board
A2: J1.12, U8.11 (A2), U13.6 (A2); also elsewhere on the board
A3: J1.15, U8.12 (A3), U13.5 (A3); also elsewhere on the board
A4: J1.16, U8.13 (A4), U13.4 (A4); also elsewhere on the board
A5: J1.17, U8.14 (A5), U13.3 (A5); also elsewhere on the board
A6: J1.18, U8.15 (A6), U13.2 (A6); also elsewhere on the board
A7: J1.19, U8.16 (A7), U13.1 (A7); also elsewhere on the board
A8: J1.20, U8.17 (A8), U13.23 (A8); also elsewhere on the board
A9: J1.21, U8.18 (A9), U13.22 (A9); also elsewhere on the board
A10: J1.22, JP2.1 (A), U8.19 (A10); also elsewhere on the board
A11: J1.23, U8.20 (A11); also elsewhere on the board
A12: J1.24, U8.22 (A12); also elsewhere on the board
A13: J1.25, U8.23 (A13); also elsewhere on the board
A14: J1.26, U8.24 (A14); also elsewhere on the board
A15: J1.27, U8.25 (A15); also elsewhere on the board
AUX: J2.9; also elsewhere on the board
D0: U6.2 (R0), U6.4 (D0), U8.33 (D0), U13.9 (01), U14.22 (D0); also elsewhere on the board
D1: U6.12 (D3), U6.14 (R3), U8.32 (D1), U13.10 (02), U14.21 (D1); also elsewhere on the board
D2: U6.5 (R1), U6.7 (D1), U8.31 (D2), U13.11 (03), U14.20 (D2); also elsewhere on the board
D3: U6.9 (D2), U6.11 (R2), U8.30 (D3), U13.13 (04), U14.19 (D3); also elsewhere on the board
D4: U7.2 (R0), U7.4 (D0), U8.29 (D4), U13.14 (05), U14.18 (D4); also elsewhere on the board
D5: U7.12 (D3), U7.14 (R3), U8.28 (D5), U13.15 (06), U14.17 (D5); also elsewhere on the board
D6: U7.5 (R1), U7.7 (D1), U8.27 (D6), U13.16 (07), U14.16 (D6); also elsewhere on the board
D7: U7.9 (D2), U7.11 (R2), U8.26 (D7), U13.17 (08), U14.15 (D7); also elsewhere on the board
DD: J1.3, R9.1, R174.2, U6.1 (RE), U6.15 (BE), U7.1 (RE), U7.15 (BE)
ERx CLOCK: J2.2, R42.1, R43.2, U67.1
ERx DATA: J2.1, R40.1, R41.2, U67.13
ETx CLOCK: J2.5, R46.1, R47.2, U68.10 (5Y)
ETx DATA: J2.4, R48.1, R49.2, U68.8 (4Y)
GND: J1.8, J1.9, J1.10, J1.28, J1.29, J1.30, J1.37, J1.38, J1.39, J1.40, J2.8, J2.11, JP3.1 (A), JP6.2 (B), R39.1, R41.1, R43.1, R45.1, R47.1, R49.1, R174.1, U8.1 (Vss), U8.21 (Vss), U8.38 (SO); also elsewhere on the board
J2 ~CTS: J2.3, R38.1, R39.2, U67.5
MIC: J2.7; also elsewhere on the board
MON: J2.10; also elsewhere on the board
unnamed: J1.11, PIN15.1
unnamed: JP1.2 (B), JP2.2 (B), JP3.2 (B), U13.19 (A10)
unnamed: JP4.2 (B), U13.18 (CS2)
unnamed: JP5.2 (C), U13.20 (CS1)
unnamed: JP6.1 (A), U14.23 (~DCD)
unnamed: JP7.1 (A), U14.24 (~CTS)
unnamed: JP8.1 (A), U14.4 (Tx_CLOCK)
unnamed: JP9.2 (C), U14.3 (Rx_CLOCK)
unnamed: JP9.3 (B), U67.4
unnamed: PIN16.1, U18.4
unnamed: U14.5 (~RTS), U68.13 (6A)
unnamed: U14.6 (Tx_DATA), U18.13
unnamed: U18.10, U68.9 (4A)
unnamed: U67.2, U67.3
unnamed: U67.6, U67.9
unnamed: U67.11, U67.12
RTS: J2.6, R44.1, R45.2, U68.12 (6Y)
R/~W: J1.32, U8.34 (R/~W), U14.13 (R/~W); also elsewhere on the board
VIDEO OUT: J2.12; also elsewhere on the board
~A10: U14.10 (CS1); also elsewhere on the board
~A11: U14.8 (CS0); also elsewhere on the board
~ACS: U14.9 (~CS2); also elsewhere on the board
~BD0: J1.4, U6.3 (B0)
~BD1: J1.5, U6.13 (B3)
~BD2: J1.6, U6.6 (B1)
~BD3: J1.7, U6.10 (B2)
~BD4: J1.36, U7.3 (B0)
~BD5: J1.35, U7.13 (B3)
~BD6: J1.34, U7.6 (B1)
~BD7: J1.33, U7.10 (B2)
~IRQ: J1.1, R11.1, U8.4 (~IRQ)
~MCS: JP4.1 (A), U18.3; also elsewhere on the board
~NMI: J1.2, R10.1, U8.6 (~NMI)
~RESET: U8.40 (~RES); also elsewhere on the board
~Φ2: JP5.1 (A), U21.4; also elsewhere on the board
Φ0 IN: U8.37 (Φ0); also elsewhere on the board
Φ2: J1.31, JP5.3 (B), U8.39 (Φ2), U14.14 (E), U21.3; also elsewhere on the board

Notes on the sheet:
J2 (2)
J2 (5)
J2 (1)
* NORMALLY NOT INSTALLED * NOTE: ~{CTS} and (~{CTS}) are different signals(!)
* Φ1 out and SYNC are not connected
2K x 8 BOOT ROM
J2 (6)
* ~{IRQ} is not connected
J2 (4)
* CE3/Vpp (21) +5V
J2 (3)

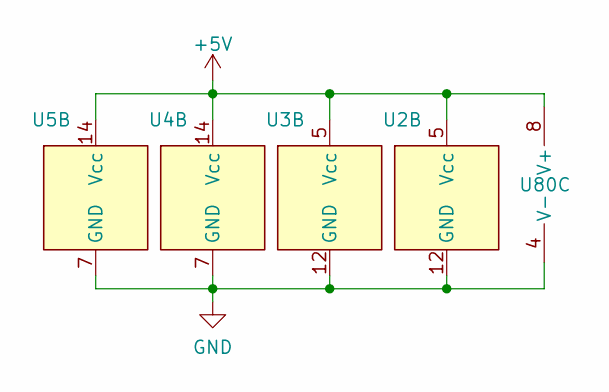
[picture p28: schematic sheet5of5power.kicad_sch, SUPERBOARD 2 MODEL 600 REV. D]

Parts:
U2, U3: LS75; DIP-16_W7.62mm_Socket_LongPads
U4, U5: LS125; DIP-14_W7.62mm_Socket_LongPads
U80: LM393; DIP-8_W7.62mm_Socket_LongPads

Connections:
+5V: U2.5 (Vcc), U3.5 (Vcc), U4.14 (Vcc), U5.14 (Vcc), U80.8 (V+); also elsewhere on the board
GND: U2.12 (GND), U3.12 (GND), U4.7 (GND), U5.7 (GND), U80.4 (V-); also elsewhere on the board

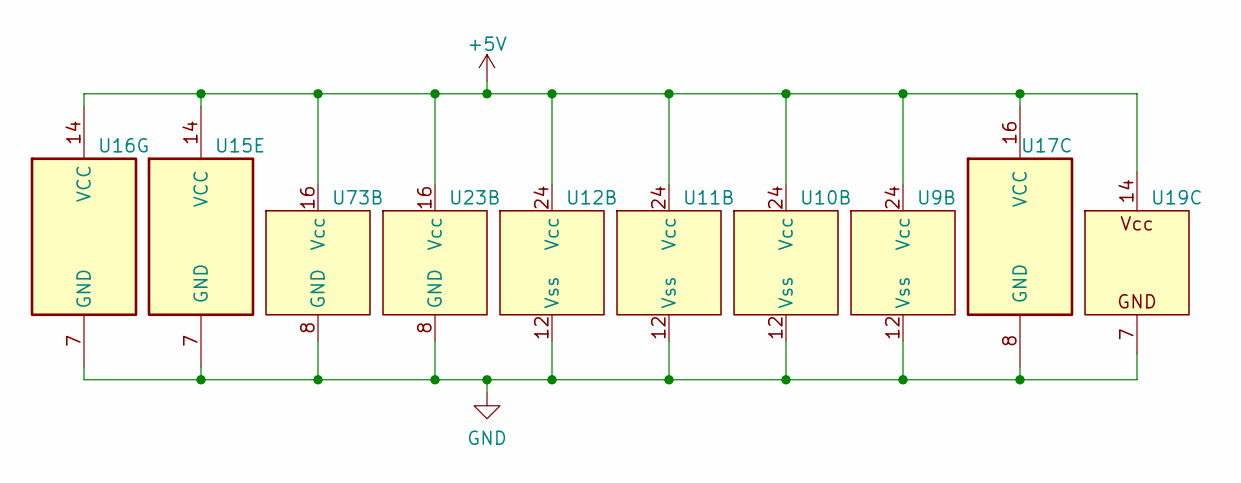
[picture p29: schematic sheet2of5power.kicad_sch, SUPERBOARD 2 MODEL 600 REV. D]

Parts:
U9: BASIC 1; DIP-24_W15.24mm_Socket_LongPads
U10: BASIC 2; DIP-24_W15.24mm_Socket_LongPads
U11: BASIC 3; DIP-24_W15.24mm_Socket_LongPads
U12: BASIC 4; DIP-24_W15.24mm_Socket_LongPads
U15: LS02; DIP-14_W7.62mm_Socket_LongPads
U16: LS04; DIP-14_W7.62mm_Socket_LongPads
U17: LS139; DIP-16_W7.62mm_Socket_LongPads
U19: LS20; DIP-14_W7.62mm_Socket_LongPads
U23, U73: LS138; DIP-16_W7.62mm_Socket_LongPads

Connections:
+5V: U9.24 (Vcc), U10.24 (Vcc), U11.24 (Vcc), U12.24 (Vcc), U15.14 (VCC), U16.14 (VCC), U17.16 (VCC), U19.14 (Vcc), U23.16 (Vcc), U73.16 (Vcc); also elsewhere on the board
GND: U9.12 (Vss), U10.12 (Vss), U11.12 (Vss), U12.12 (Vss), U15.7 (GND), U16.7 (GND), U17.8 (GND), U19.7 (GND), U23.8 (GND), U73.8 (GND); also elsewhere on the board

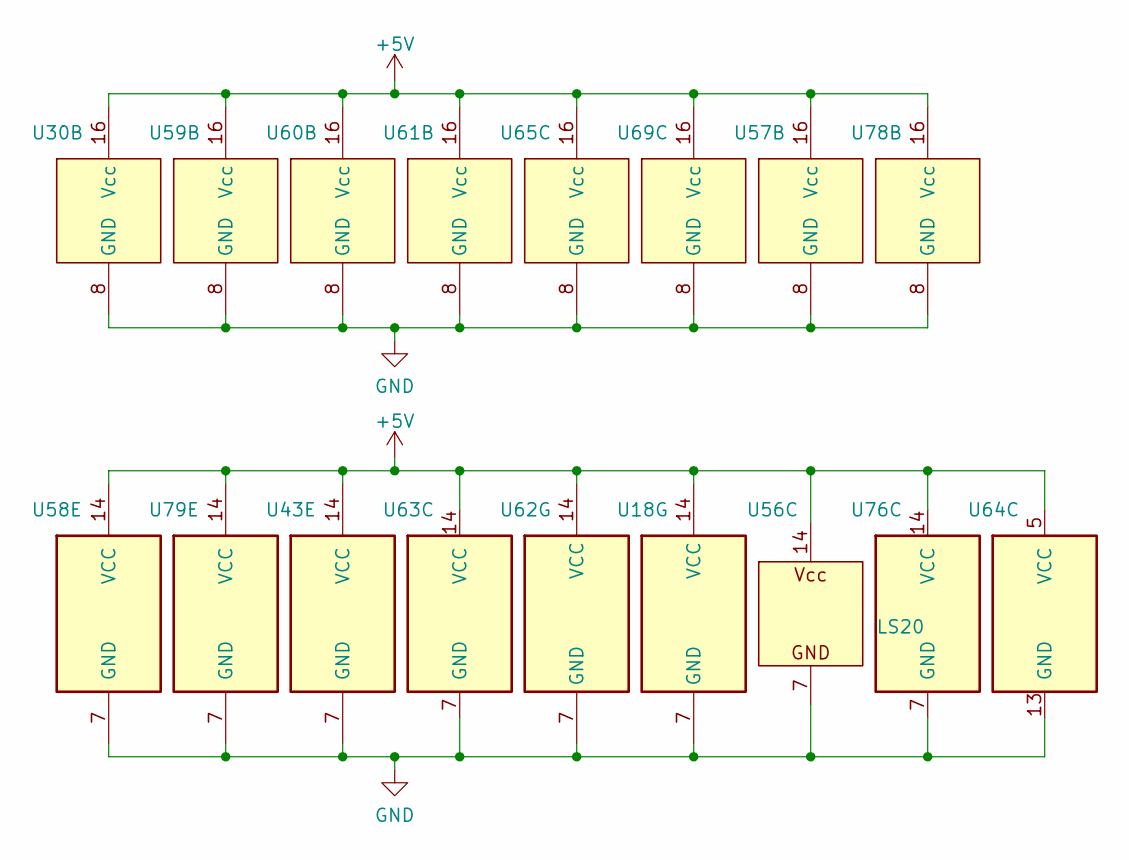
[picture p30: schematic sheet3of5power.kicad_sch, SUPERBOARD 2 MODEL 600 REV. D]

Parts:
U18, U62: LS04; DIP-14_W7.62mm_Socket_LongPads
U30, U57, U59, U60, U61: LS163; DIP-16_W7.62mm_Socket_LongPads
U43: '08; DIP-14_W7.62mm_Socket_LongPads
U56: LS20; DIP-14_W7.62mm_Socket_LongPads
U58: '00; DIP-14_W7.62mm_Socket_LongPads
U63, U76: '74; DIP-14_W7.62mm_Socket_LongPads
U64: LS76; DIP-16_W7.62mm_Socket_LongPads
U65, U69: '123; DIP-16_W7.62mm_Socket_LongPads
U78: LS157; DIP-16_W7.62mm_Socket_LongPads
U79: LS86; DIP-14_W7.62mm_Socket_LongPads

Connections:
+5V: U18.14 (VCC), U30.16 (Vcc), U43.14 (VCC), U56.14 (Vcc), U57.16 (Vcc), U58.14 (VCC), U59.16 (Vcc), U60.16 (Vcc), U61.16 (Vcc), U62.14 (VCC), U63.14 (VCC), U64.5 (VCC), U65.16 (Vcc), U69.16 (Vcc), U76.14 (VCC), U78.16 (Vcc), U79.14 (VCC); also elsewhere on the board
GND: U18.7 (GND), U30.8 (GND), U43.7 (GND), U56.7 (GND), U57.8 (GND), U58.7 (GND), U59.8 (GND), U60.8 (GND), U61.8 (GND), U62.7 (GND), U63.7 (GND), U64.13 (GND), U65.8 (GND), U69.8 (GND), U76.7 (GND), U78.8 (GND), U79.7 (GND); also elsewhere on the board

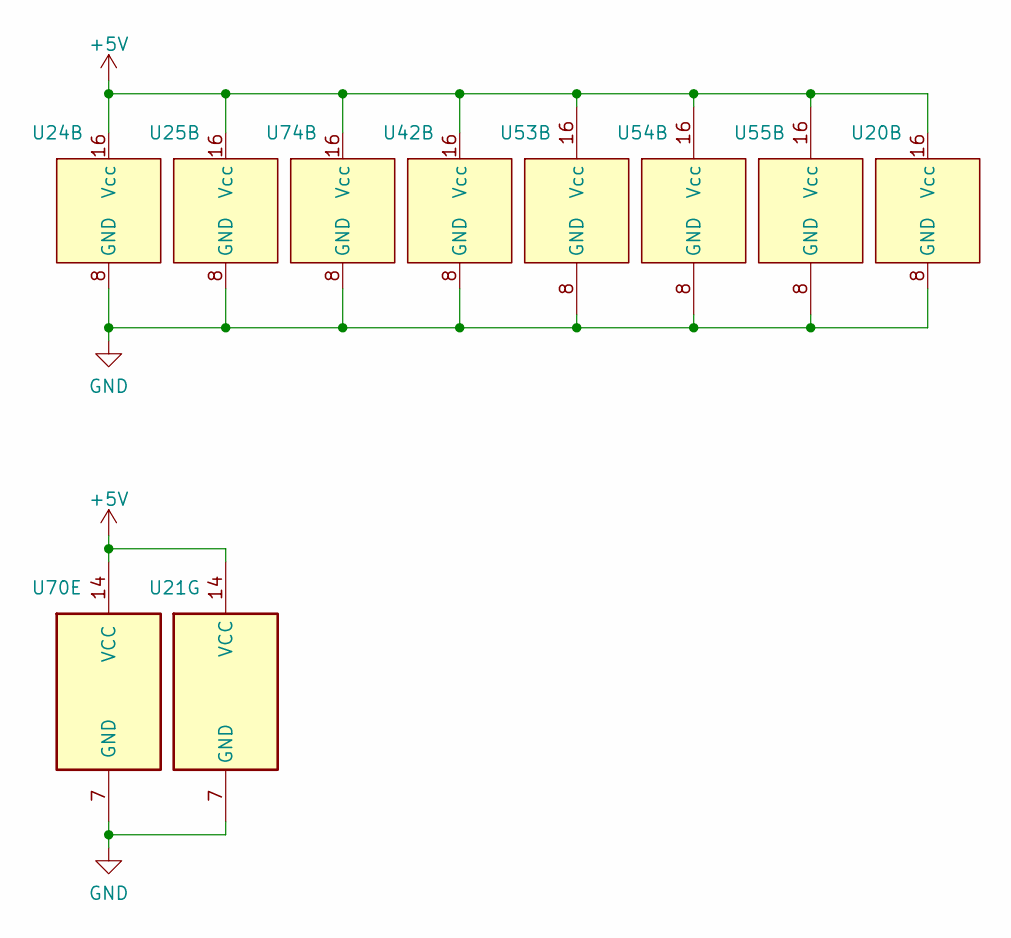
[picture p31: schematic sheet4of5power.kicad_sch, SUPERBOARD 2 MODEL 600 REV. D]

Parts:
U20: LS138; DIP-16_W7.62mm_Socket_LongPads
U21: LS04; DIP-14_W7.62mm_Socket_LongPads
U24, U25, U74: 8T28; DIP-16_W7.62mm_Socket_LongPads
U42: LS165; DIP-16_W7.62mm_Socket_LongPads
U53, U54, U55: LS157; DIP-16_W7.62mm_Socket_LongPads
U70: '03; DIP-14_W7.62mm_Socket_LongPads

Connections:
+5V: U20.16 (Vcc), U21.14 (VCC), U24.16 (Vcc), U25.16 (Vcc), U42.16 (Vcc), U53.16 (Vcc), U54.16 (Vcc), U55.16 (Vcc), U70.14 (VCC), U74.16 (Vcc); also elsewhere on the board
GND: U20.8 (GND), U21.7 (GND), U24.8 (GND), U25.8 (GND), U42.8 (GND), U53.8 (GND), U54.8 (GND), U55.8 (GND), U70.7 (GND), U74.8 (GND); also elsewhere on the board

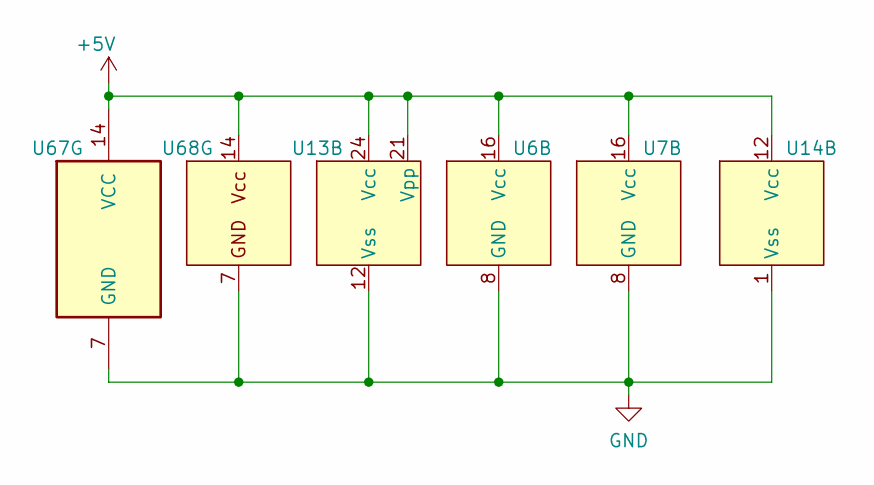
[picture p32: schematic sheet1of5power.kicad_sch, SUPERBOARD 2 MODEL 600 REV. D]

Parts:
U6, U7: 8T28; DIP-16_W7.62mm_Socket_LongPads
U13: 2316B/2716; DIP-24_W15.24mm_Socket_LongPads
U14: 6850; DIP-24_W15.24mm_Socket_LongPads
U67: LS14; DIP-14_W7.62mm_Socket_LongPads
U68: '17; DIP-14_W7.62mm_Socket_LongPads

Connections:
+5V: U6.16 (Vcc), U7.16 (Vcc), U13.21 (Vpp), U13.24 (Vcc), U14.12 (Vcc), U67.14 (VCC), U68.14 (Vcc); also elsewhere on the board
GND: U6.8 (GND), U7.8 (GND), U13.12 (Vss), U14.1 (Vss), U67.7 (GND), U68.7 (GND); also elsewhere on the board
