ivop/osi600d/kicad/OSI600D.kicad_pcb

## KiCad design kicad/OSI600D.kicad_pcb (continued)

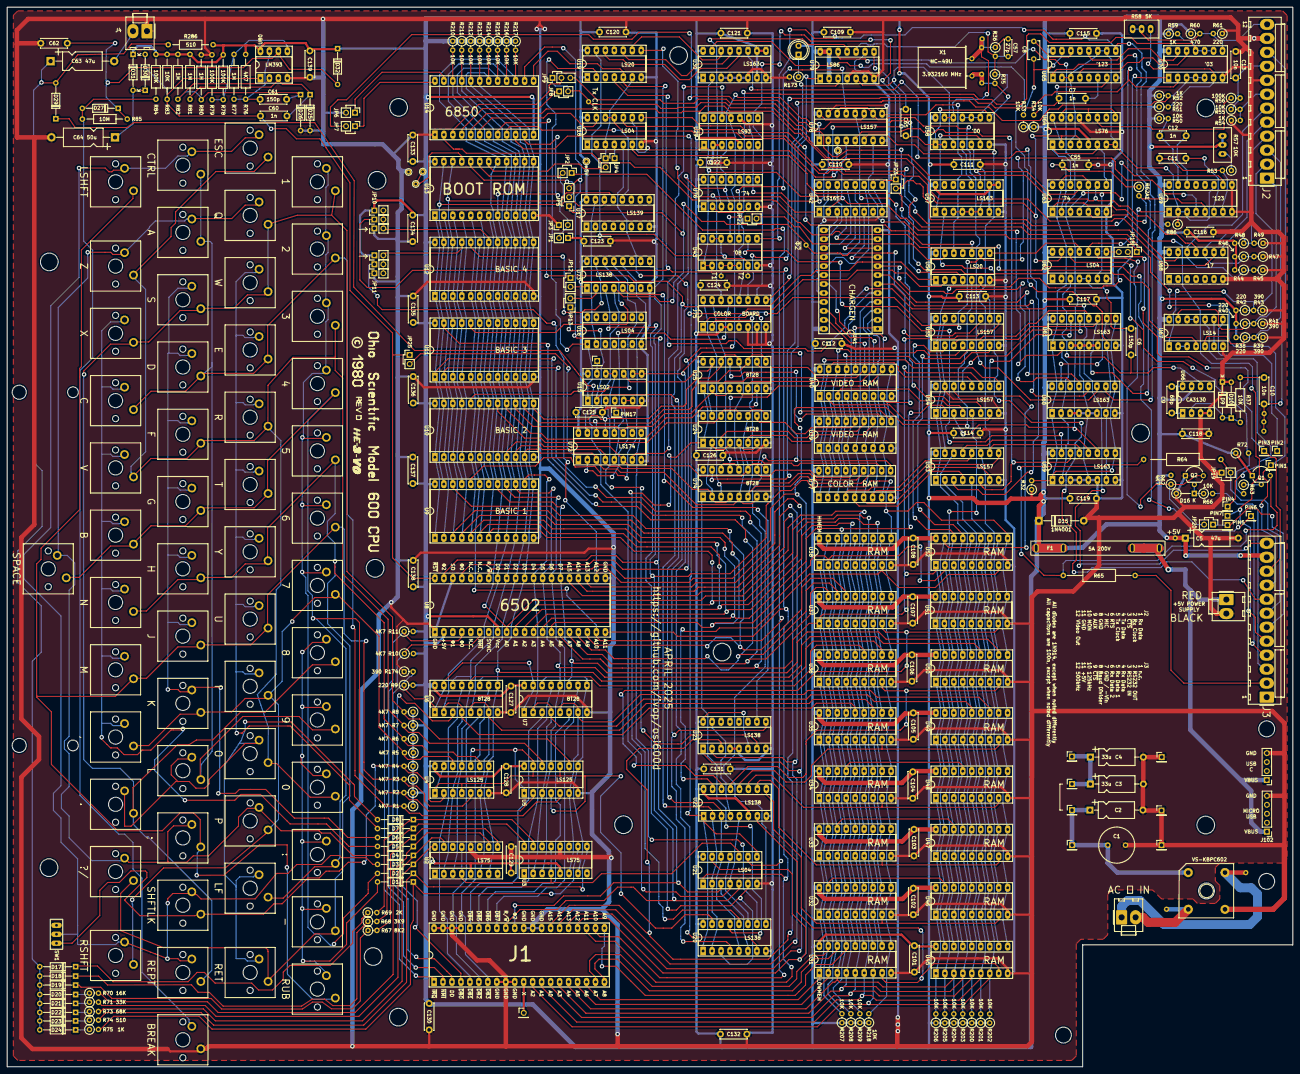
[picture p33: board OSI600D.kicad_pcb from above]

Board: 2 copper layers, 364.0 x 300.0 mm, 385 parts (1 on the bottom side), 291 nets.

Other parts of the board:
nis-+5v-1: +5V
nis-C65-pad1: (no value)
nis-MON-pad: (no value)
nis-MON-pad-2: (no value)
nis-c65-pad1-2: (no value)
nis-phi2: ~{Φ2}
nis-rectifier-pad: (no value)

Their connections:
+5V: nis-+5v-1.1; also elsewhere on the board
MON: nis-C65-pad1.1, nis-MON-pad.1, nis-MON-pad-2.1; also elsewhere on the board
unnamed 106: nis-c65-pad1-2.1; also elsewhere on the board
unnamed 171: nis-rectifier-pad.1; also elsewhere on the board
~Φ2: nis-phi2.1; also elsewhere on the board
