ivop/osi600d/(commit log)

2025-04-29 First commit.
    [41791-0832.stp, 417910842.stp, Clips LF-102071 with fuse 6_3x32.STEP, OSI600D.kicad_pcb, OSI600D.kicad_sch, SS12D00G4.STEP, SW_Cherry_MX_PCB.stp, SW_Cherry_MX_Plate.stp]
2025-05-08 Switch J1 and J75 to pin headers.
    [OSI600D.kicad_pcb]
2025-06-01 Fix number of 18-pin sockets
    [osi600d-bom.ods]
2025-07-19 Fix comments in schematic
    [sheet1of5.kicad_sch, sheet4of5.kicad_sch]
2025-08-01 Add Micro USB Power component (5-pin breakout board)
    [OSI600D.kicad_pcb, OSI600D.kicad_sch, extracomponents.kicad_sch]
2025-08-18 small update of silkscreen, remove sch-bak file(s)
    [OSI600D.kicad_pcb]
2026-11-07 upload gerbers
    [OSI600D-B_Cu.gbl, OSI600D-B_Mask.gbs, OSI600D-B_Paste.gbp, OSI600D-B_Silkscreen.gbo, OSI600D-Edge_Cuts.gm1, OSI600D-F_Cu.gtl, OSI600D-F_Mask.gts, OSI600D-F_Paste.gtp]
2026-11-08 Fix Gerbers, include all data in silkscreen
    [OSI600D-B_Cu.gbl, OSI600D-B_Mask.gbs, OSI600D-B_Paste.gbp, OSI600D-B_Silkscreen.gbo, OSI600D-Edge_Cuts.gm1, OSI600D-F_Cu.gtl, OSI600D-F_Mask.gts, OSI600D-F_Paste.gtp]
