ivop/osi600d/(notices)

Notices in the files:
kicad/3dmodels/417910842.stp:
author */ ('License CC BY-ND 4.0'),
